vdmulato/EEC136AB-Winter2023-India-Digital-Camera/Pictures/Multiplexer test circuit.jpeg

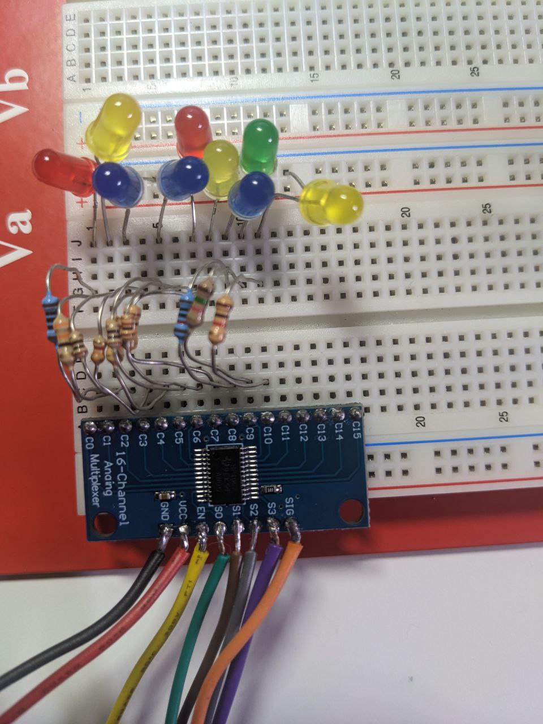
Pictures/Multiplexer test circuit.jpeg
