vdmulato/EEC136AB-Winter2023-India-Digital-Camera/Pictures/Fixed issues.jpg

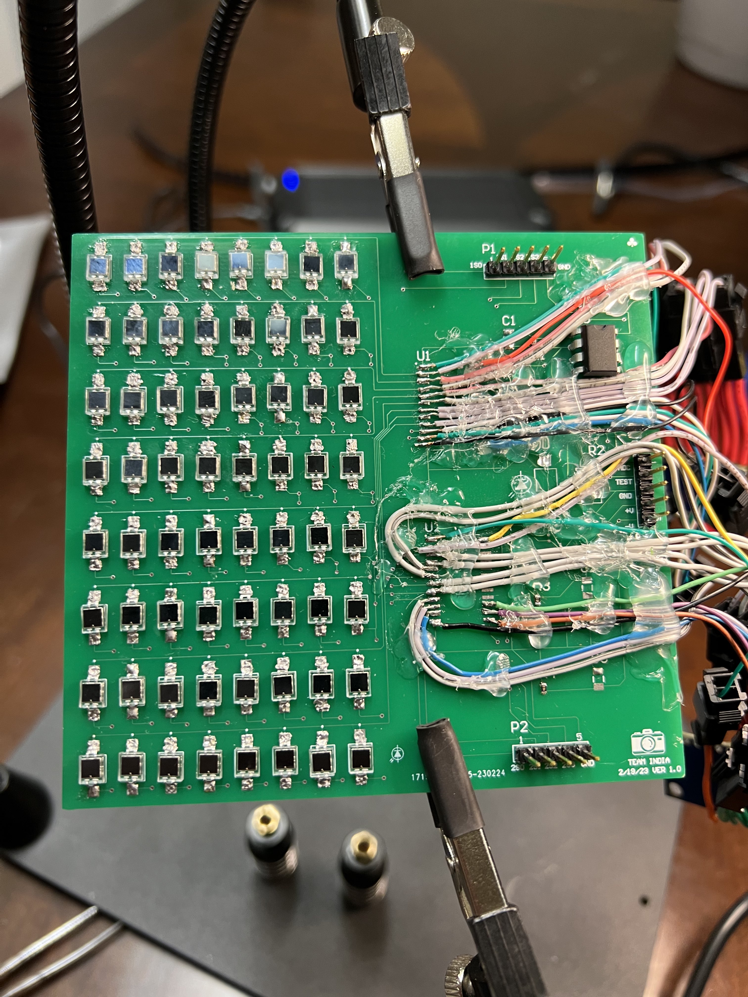
Pictures/Fixed issues.jpg
