vdmulato/EEC136AB-Winter2023-India-Digital-Camera/Weekley reports/Week 5/Week 5 Update.pdf

# EEC136 Digital Camera

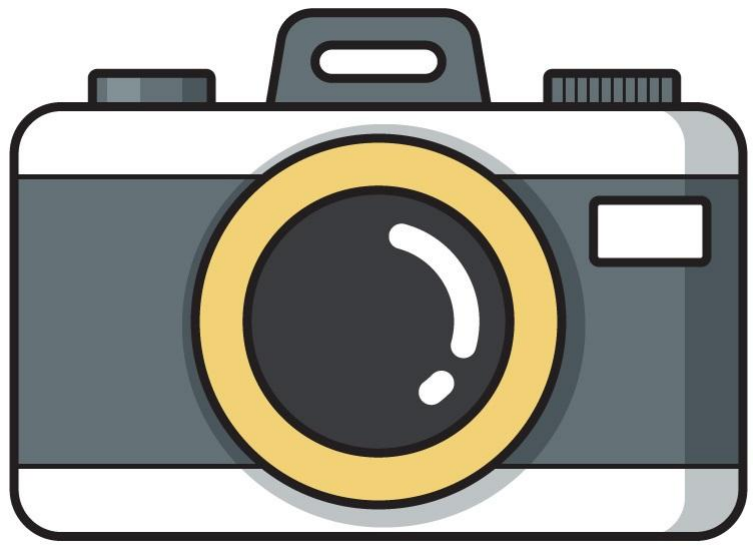
[picture p12: figure]

## Week 5 Project Update

## Waylon, Cassandra, Viktor, Alina, Angel

# Overview

## 1. Received PSoC boards and began assembly 2. Finalized Beta Prototype Design 3. Improved and optimized Matlab code 4. Translating Design into Altium. Intend to order PCB for photodiodes by mid next week 5. Filmed presentation video

# Waylon

This week:

- Filmed and edited presentation video
- Updated Beta Prototype Circuit and designed in LTSpice
- Finalized BOM
- Calculated power consumption and submitted videos

Next week:

- Translate LTSpice design into Altium
- Place order for Photodiode and transimpedance amplifier board
- Place order for parts needed for PCB assembly
- Test PSoC board to fix ground issue
- Begin designs for physical enclosure.

# Alina

This week:

- Hardware - Tested out the multiplexer on the breadboard with Viktor
- Researched other ways of what to include since multiplexer has problems. Researched mosfet and multiplexer parts.

Plans for next week:

- PCB Design - Send a PCB layout to the manufacturer
- Hardware - Test out the connections of the PCB custom PSoC

# Viktor

This week:

- Hardware -Worked with the team to put the Psoc custom board together.
- Worked with the team to conceptualize the last week feedback on the new final design.
- Double checked multiplexer behavior with Alina.
- Management- Recorded the presentation video with the team and recorder the firmware video with Angel.

Plans for next week:

- PCB Design - Help the team on creating the Altium library with new parts.
- Hardware - Research and order new multiplexer for the final design.

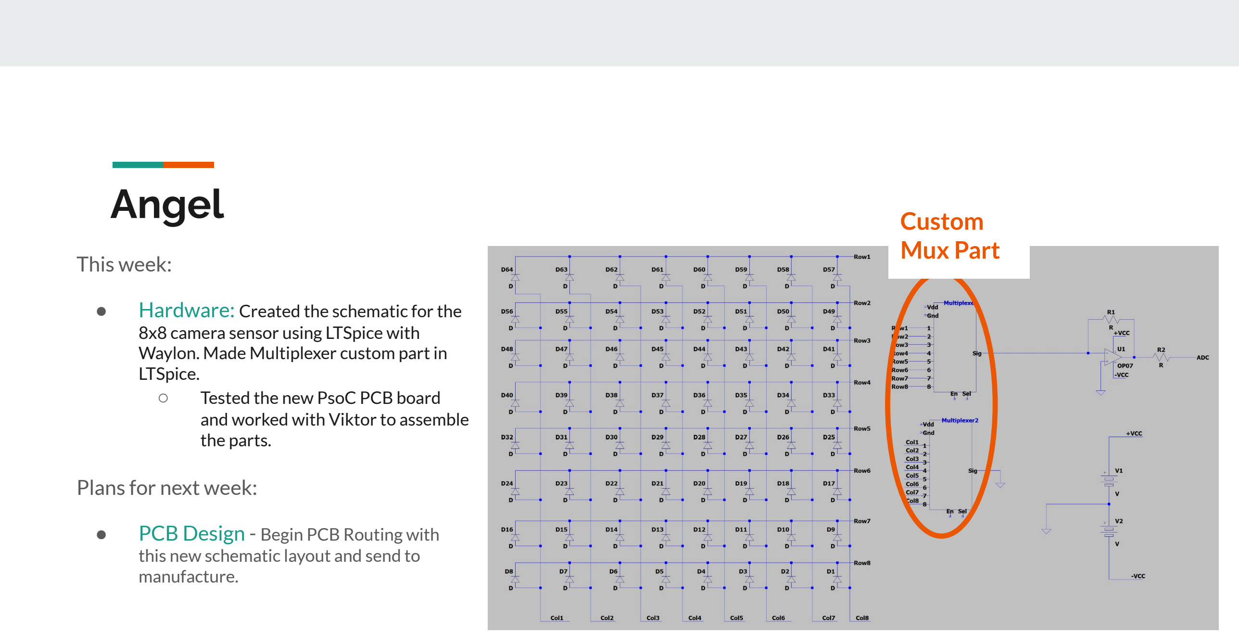
[picture p13: page 6]

# Angel

This week: ● Hardware: Created the schematic for the

8x8 camera sensor using LTSpice with Waylon. Made Multiplexer custom part in LTSpice. ○ Tested the new PsoC PCB board

and worked with Viktor to assemble the parts.

Plans for next week: ● PCB Design - Begin PCB Routing with

this new schematic layout and send to manufacture.

Custom
Mux Part

# Cassandra

This week:
- Software - Upgraded
MATLAB image
processing code to
accept any size of
(square) pixel array
- Misc - Assisted with
board testing, design
finalization, video
recording

Plans for next week:

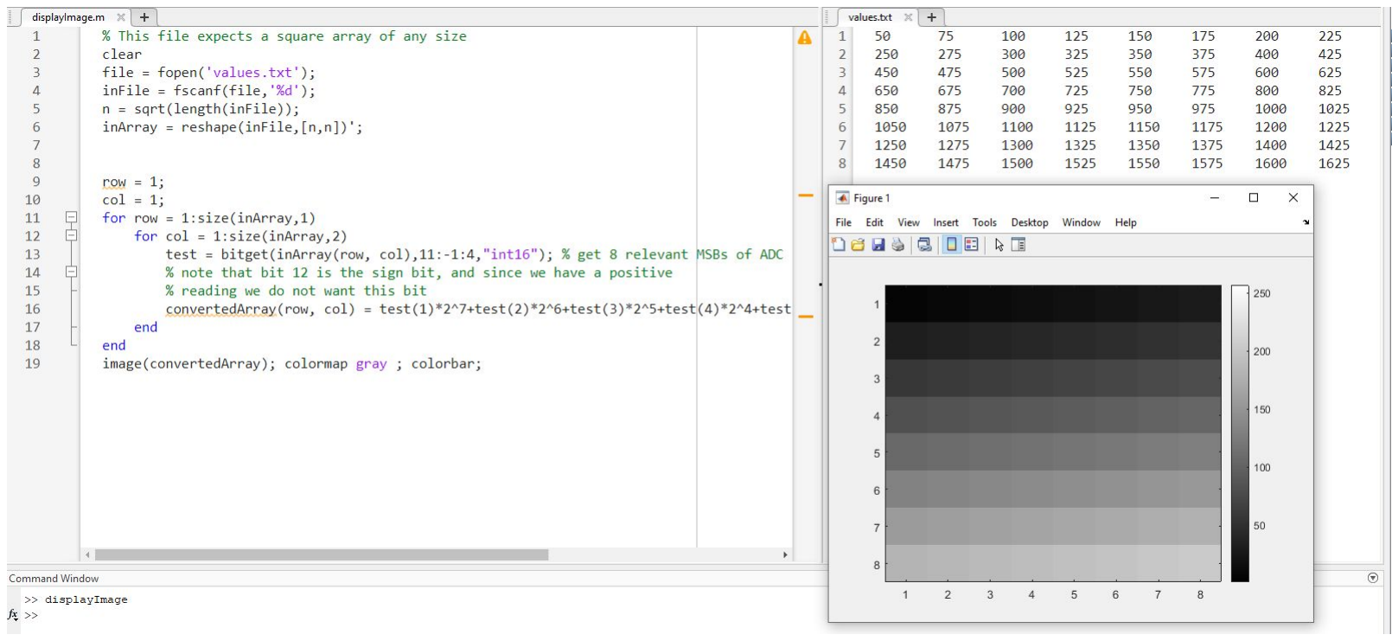
[picture p14: figure]

- Software - Further refine MATLAB code to process files generated by PuTTY
- Hardware - Assist with soldering and testing prototype boards and new components

# Reference Images

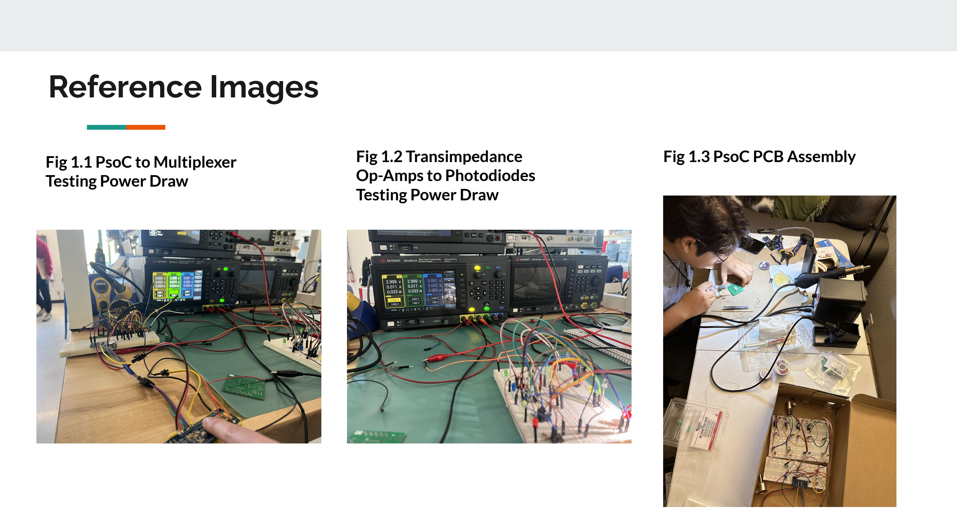
[picture p15: page 8]

Fig 1.1 PsoC to Multiplexer Testing Power Draw

Fig 1.2 Transimpedance
Op-Amps to Photodiodes
Testing Power Draw

Fig 1.3 PsoC PCB Assembly

# Reference Images

Fig 1.4 Sensor PCB Schematic

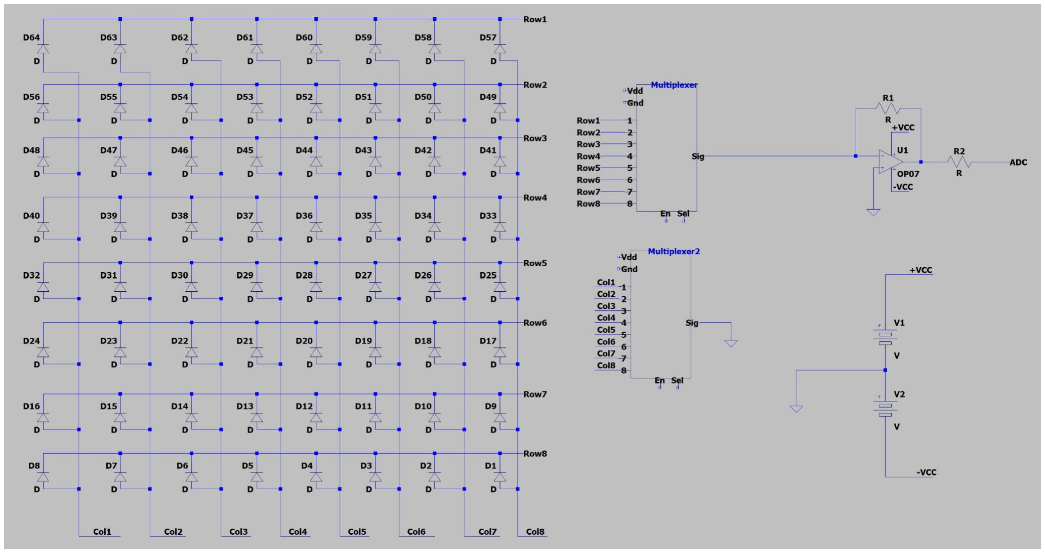
[picture p16: figure]
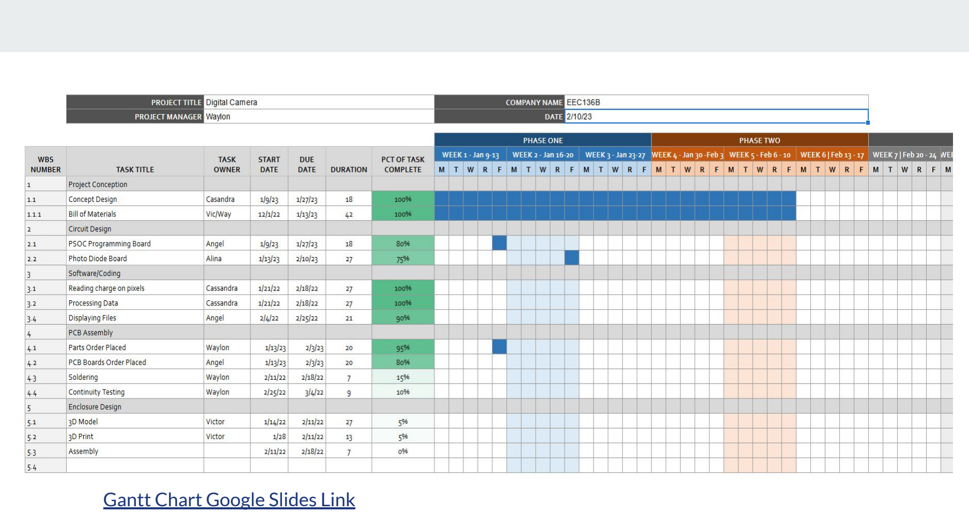
[picture p17: page 10]

Gantt Chart Google Slides Link (https://docs.google.com/spreadsheets/d/1wo6-4W0_o3KltN52uBX6xlA9TMSRVw0D3fkvswnoc7U/edit?usp=sharing)

# Bill of Materials Page 1 of 2

Item | Part No. | QTY | Cost | Received
Photodiode (final board) | VBPW34S (https://www.mouser.com/ProductDetail/Vishay-Semiconductors/VBPW34S?qs=Uj7aA%252BCqp8ZDwjFKEZ8K8A%3D%3D) | 64 | $54.00
MOSFET (n-type) | SQ1922AEEH-T1_GE3 (https://www.mouser.com/ProductDetail/Vishay-Siliconix/SQ1922AEEH-T1_GE3?qs=vLWxofP3U2xgTHPynqtGhQ%3D%3D) | 200 | $60.20 | X
Button | 474-COM-08720 | 5 | $5.25 | X
Header Pins | HDR100IMP40M-G-V-TH | 10 | $4.95 | X
PSOC | CYBLE-416045-02 | 2 | TBD | X
Crystal Oscillator | ECS-2520MV-250-CL-TR | 1 | TBD | X
Battery | LIPO Battery (3.7V) (https://www.sparkfun.com/products/13854) | 1 | $10.95 | X
OLED Display | LCD-13003 (https://www.digikey.com/en/products/detail/sparkfun-electronics/LCD-13003/5673774) | 2 | $35.76
Tri-LED | HSMD-C191 (https://www.mouser.com/ProductDetail/Broadcom-Avago/HSMD-C191?qs=YDL0qNrpDT5JaOo6lomf0A%3D%3D) | 5 | TBD | X
Multiplexer | BOB-13906 (https://www.digikey.com/en/products/detail/sparkfun-electronics/BOB-13906/6193600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) | 2 | $5.90

# Bill of Materials Page 2 of 2

Item | Part No. | QTY | Cost | Received
10KΩ Resistor | 3503G2B10K7FTDF (https://www.mouser.com/ProductDetail/TE-Connectivity-Holsworthy/3503G2B10K7FTDF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) | 4 | $6.56 | X
0Ω Resistor | MCT0603HZ0000ZP500 (https://www.mouser.com/ProductDetail/Vishay-Beyschlag/MCT0603HZ0000ZP500) | 10 | $6.10 | X
1KΩ Resistor | RA73F1J143RBTDF | 2 | $3.88 | X
10uF Capacitor | GMK316BJ106KL-T | 1 | $0.33 | X
22pF Capacitor | 12065A220JAT2A (https://www.mouser.com/ProductDetail/KYOCERA-AVX/12065A220JAT2A) | 2 | $2.80 | X
4.7KΩ Resistor | 263-4.7K-RC (https://www.mouser.com/ProductDetail/Xicon/263-4.7K-RC?qs=a0v42acnAci7EwAcARtcvw%3D%3D) | 2 | $0.20 | X
330Ω Resistor | CMP0805-FX-3300ELF (https://www.mouser.com/ProductDetail/Bourns/CMP0805-FX-3300ELF?qs=TiOZkKH1s2RwjX33o416uQ%3D%3D) | 1 | $0.21 | X
220Ω Resistor | CRGCQ2512F220K (https://www.mouser.com/ProductDetail/TE-Connectivity-Holsworthy/CRGCQ2512F220K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) | 8 | $3.68 | X
470Ω Resistor | CRG0603F470R | 1 | $0.14 | X
