vdmulato/EEC136AB-Winter2023-India-Digital-Camera/Weekley reports/Week 6/Week 6 Update.pdf

# EEC136 Digital Camera

# Week 6 Project Update


# Waylon, Cassandra, Viktor, Alina, Angel

# Overview

## 1. Assembled PSoC boards 2. Tested out the ADC component 3. Improved and optimized Matlab code 4. Finalized Altium design for the photodiodes

# Waylon

This week:

- Worked with Viktor to resolve issues with ADC.
- Worked with Alina to create PCB in Altium.
- Finalized orders for necessary SMD components.

Next week:

- Place order for PCB this weekend after Altium designs are finalized.
- Work with Viktor and Angel with any coding optimizations while waiting for boards.
- Begin developing final report and educational manual.

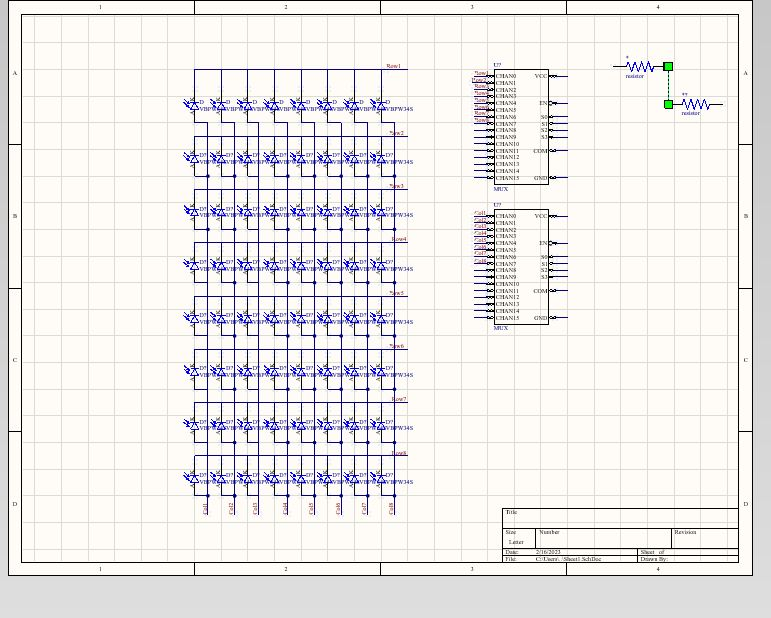
[picture p18: figure]

# Alina

This week:

- Worked on the schematic for the photodiode board on Altium to begin routing.

Plans for next week:

- PCB Design - Work on the assembly of the photodiode board if it arrives
- Hardware - Test out the ways of how to get ADC working

# Viktor

This week:

- Worked through issues with grounding causing erroneous readings on the ADC and Multiplexers.
- Updated PSoC code that allowed ADC readings to occur at the same time as multiplexer switching causing erroneous readings.

Plans for next week:

- Receive photodiode PCBs and begin assembly.
- Work with team on developing final report.

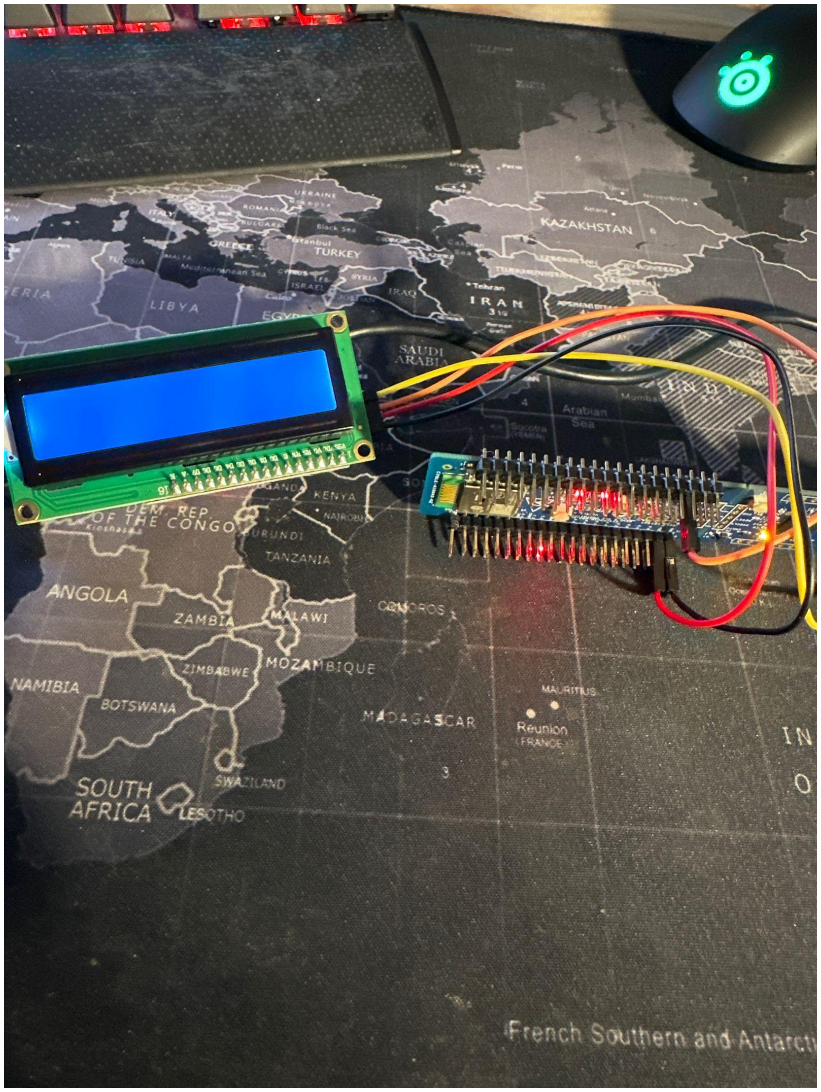
[picture p19: figure]

# Angel

This week:

- Hardware: Figuring out a way to communicate to a LCD screen with I2C to display text for User Interface.
- Code: Debugged Viktor’s Psoc code to read the correct ADC values into putty for image processing.
- Researched further on UART communicating through MatLab directly from the Psoc port. Cassandra was able to implement the readings using this method, and potentially have a live code.

Plans for next week:

- Start thinking about the enclosure based on all the components that we will have.
- Focus on soldering the new PCB that will be sent to manufacture today, hopefully receive it next week.

# Cassandra

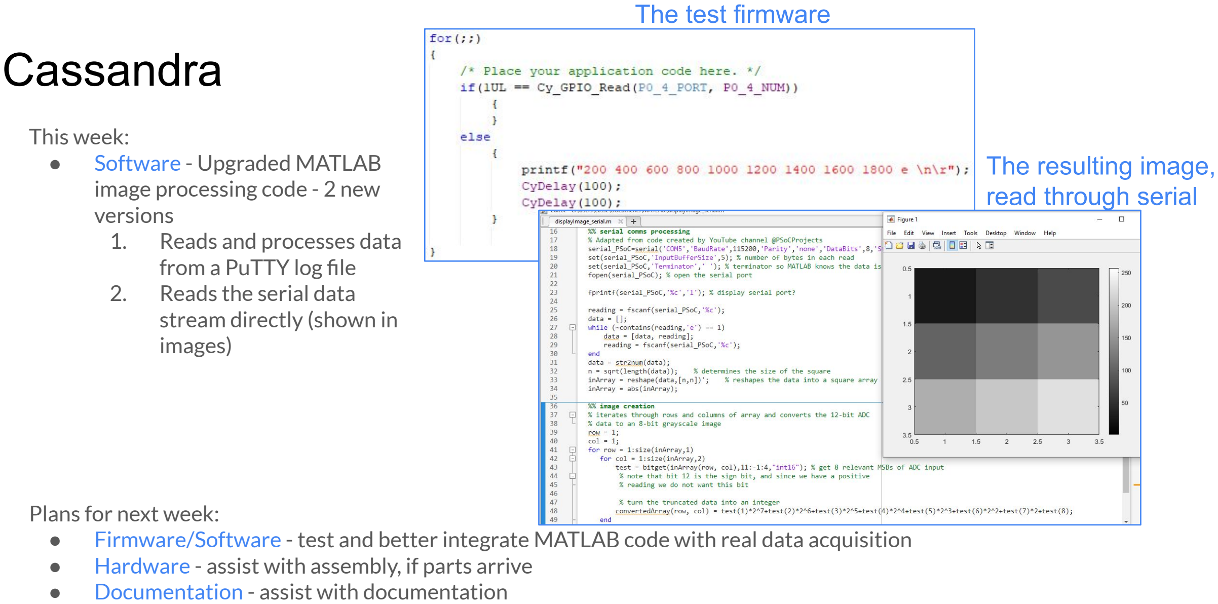
[picture p20: page 7]

This week:
- Software - Upgraded MATLAB image processing code - 2 new versions
1. Reads and processes data from a PuTTY log file
2. Reads the serial data
stream directly (shown in
images)

Plans for next week:
- Firmware/Software - test and better integrate MATLAB code with real data acquisition
- Hardware - assist with assembly, if parts arrive
- Documentation - assist with documentation

The test firmware

The resulting image,
read through serial

# Reference Images

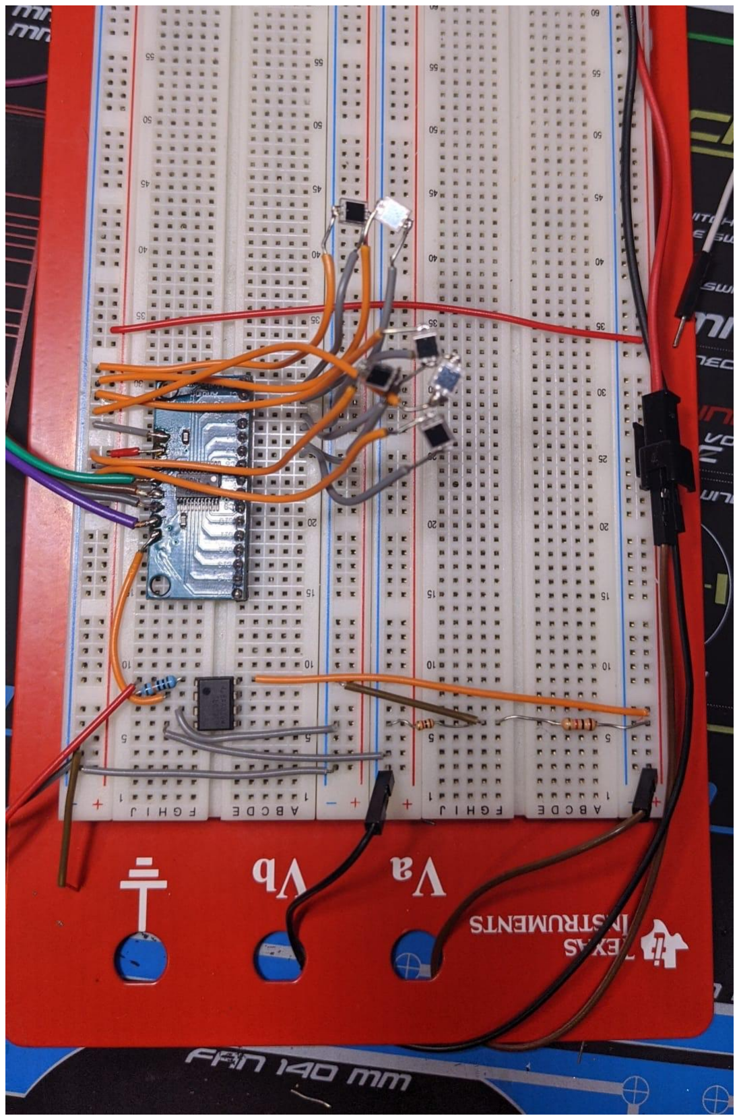
[picture p21: figure]

Fig 1.1 New Multiplexer
Layout

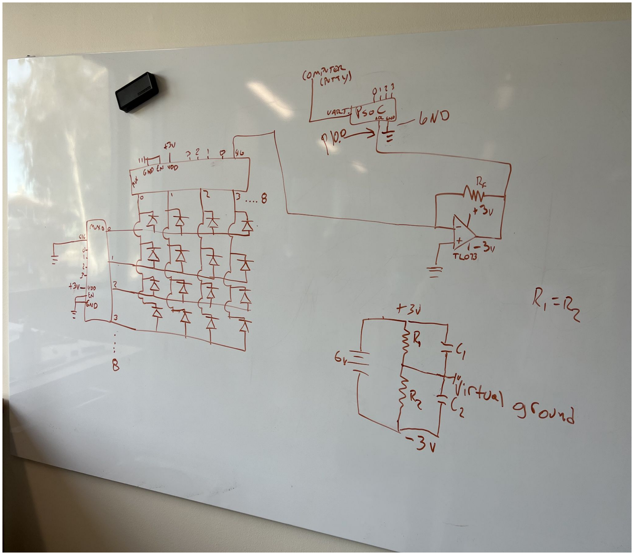
[picture p22: figure]

Fig 1.2 Whole Schematic
Diagram

Fig 1.3 PsoC PCB Assembly

# Reference Images

Fig 1.4 Sensor PCB Schematic

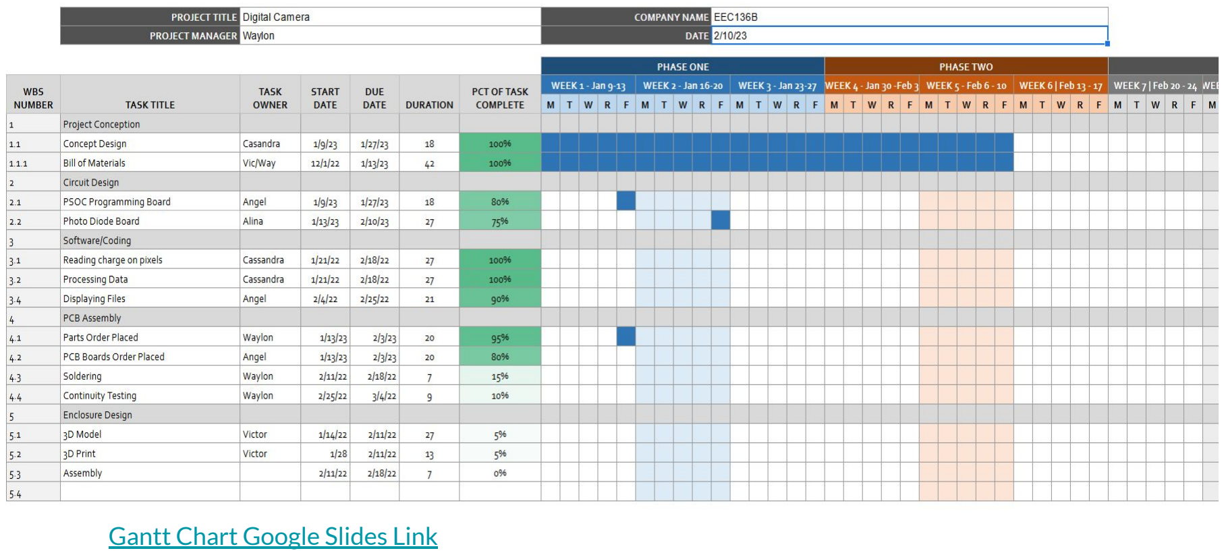
[picture p23: page 10]

Gantt Chart Google Slides Link (https://docs.google.com/spreadsheets/d/1wo6-4W0_o3KltN52uBX6xlA9TMSRVw0D3fkvswnoc7U/edit?usp=sharing)

# Bill of Materials Page 1 of 2

Item | Part No. | QTY | Cost | Received
Photodiode (final board) | VBPW34S (https://www.mouser.com/ProductDetail/Vishay-Semiconductors/VBPW34S?qs=Uj7aA%252BCqp8ZDwjFKEZ8K8A%3D%3D) | 64 | $54.00
MOSFET (n-type) | SQ1922AEEH-T1_GE3 (https://www.mouser.com/ProductDetail/Vishay-Siliconix/SQ1922AEEH-T1_GE3?qs=vLWxofP3U2xgTHPynqtGhQ%3D%3D) | 200 | $60.20 | X
Button | 474-COM-08720 | 5 | $5.25 | X
Header Pins | HDR100IMP40M-G-V-TH | 10 | $4.95 | X
PSOC | CYBLE-416045-02 | 2 | TBD | X
Crystal Oscillator | ECS-2520MV-250-CL-TR | 1 | TBD | X
Battery | LIPO Battery (3.7V) (https://www.sparkfun.com/products/13854) | 1 | $10.95 | X
OLED Display | LCD-13003 (https://www.digikey.com/en/products/detail/sparkfun-electronics/LCD-13003/5673774) | 2 | $35.76
Tri-LED | HSMD-C191 (https://www.mouser.com/ProductDetail/Broadcom-Avago/HSMD-C191?qs=YDL0qNrpDT5JaOo6lomf0A%3D%3D) | 5 | TBD | X
Multiplexer | BOB-13906 (https://www.digikey.com/en/products/detail/sparkfun-electronics/BOB-13906/6193600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) | 2 | $5.90

# Bill of Materials Page 2 of 2

Item | Part No. | QTY | Cost | Received
10KΩ Resistor | 3503G2B10K7FTDF (https://www.mouser.com/ProductDetail/TE-Connectivity-Holsworthy/3503G2B10K7FTDF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) | 4 | $6.56 | X
0Ω Resistor | MCT0603HZ0000ZP500 (https://www.mouser.com/ProductDetail/Vishay-Beyschlag/MCT0603HZ0000ZP500) | 10 | $6.10 | X
1KΩ Resistor | RA73F1J143RBTDF | 2 | $3.88 | X
10uF Capacitor | GMK316BJ106KL-T | 1 | $0.33 | X
22pF Capacitor | 12065A220JAT2A (https://www.mouser.com/ProductDetail/KYOCERA-AVX/12065A220JAT2A) | 2 | $2.80 | X
4.7KΩ Resistor | 263-4.7K-RC (https://www.mouser.com/ProductDetail/Xicon/263-4.7K-RC?qs=a0v42acnAci7EwAcARtcvw%3D%3D) | 2 | $0.20 | X
330Ω Resistor | CMP0805-FX-3300ELF (https://www.mouser.com/ProductDetail/Bourns/CMP0805-FX-3300ELF?qs=TiOZkKH1s2RwjX33o416uQ%3D%3D) | 1 | $0.21 | X
220Ω Resistor | CRGCQ2512F220K (https://www.mouser.com/ProductDetail/TE-Connectivity-Holsworthy/CRGCQ2512F220K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) | 8 | $3.68 | X
470Ω Resistor | CRG0603F470R | 1 | $0.14 | X
