vdmulato/EEC136AB-Winter2023-India-Digital-Camera/Weekley reports/Week 7/Week 7 Update.pdf

# EEC136 Digital Camera

# Week 7 Project Update


# Waylon, Cassandra, Viktor, Alina, Angel

# Overview

## 1. Sent out Photodiode board PCB to Smart Prototyping 2. Worked on code for LCD display to show camera indication 3. Ordered all parts still missing for assembly

4. Worked on beta prototype code.

## 5. Build a circuit that resembles the beta PCB to perform testing ahead

of time.

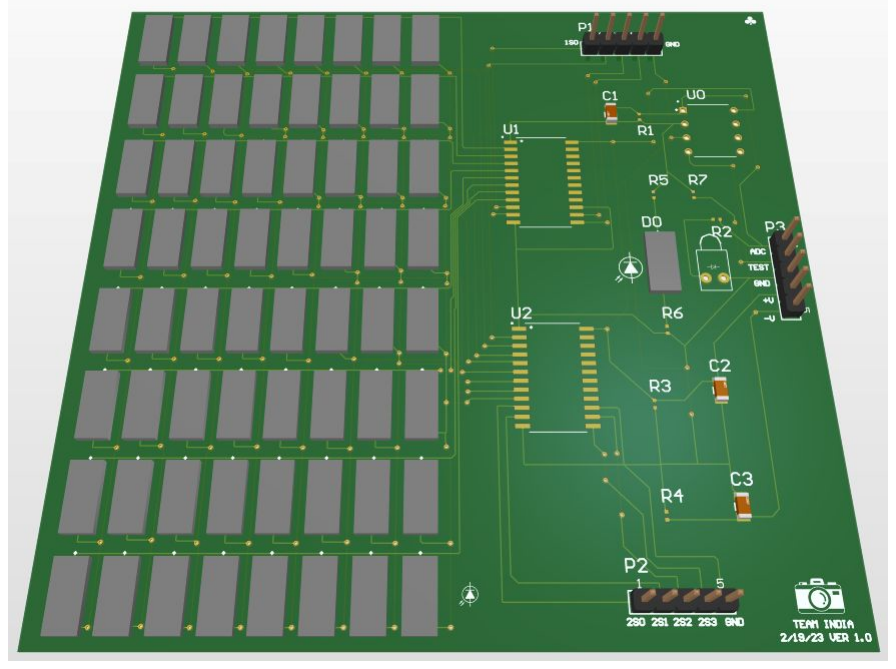
[picture p24: figure]

# Waylon

This week:

- Sent out Photodiode Board to Smart Prototyping after verifying with team.
- Placed order for all parts currently do not have.

Next week:

- Receive photodiode PCB
- Assemble PCB
- Test PCB

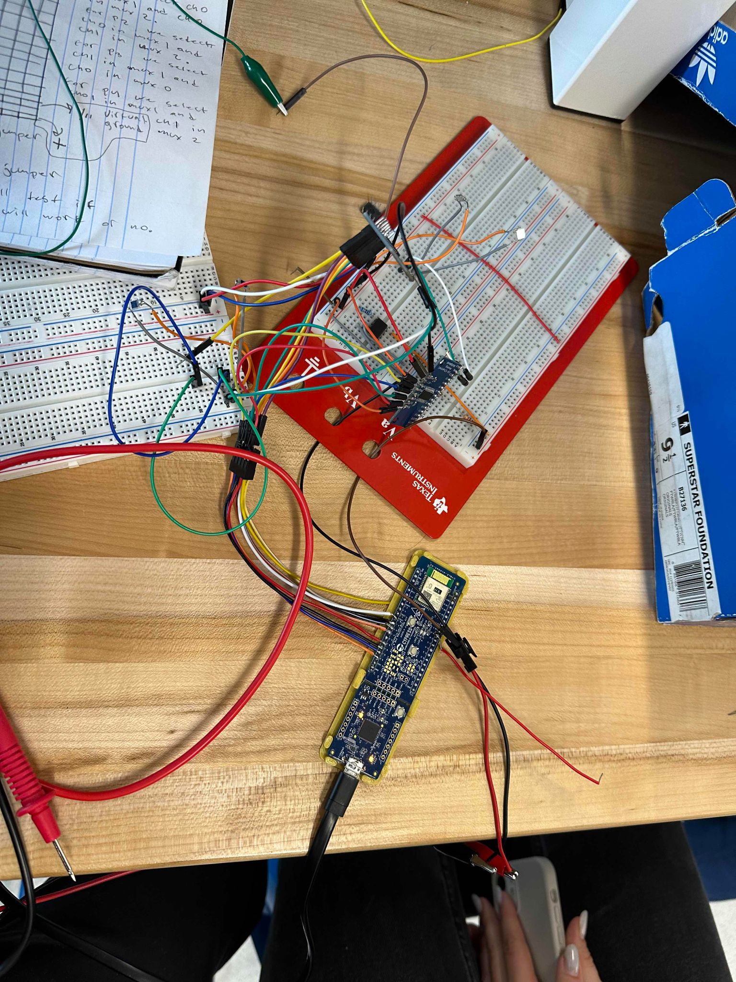
[picture p25: figure]

# Alina

This week:

- Tested out the multiplexer with Viktor to make sure it reads correct values from the selected channels

Plans for next week:

- PCB Design - Work on the assembly of the photodiode board
- Hardware - Connect the photo board with the psoc

# Viktor

This week:

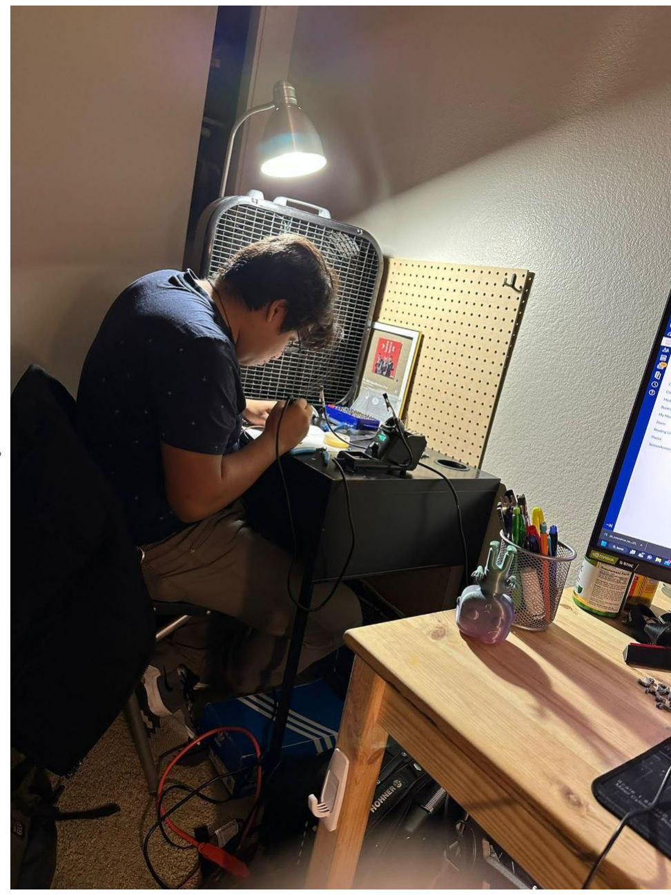
[picture p26: figure]

- Hardware : Build beta prototype circuit and perform testing ahead of time with Alina.
- Code: Updated Psoc code to account for the new PCB layout and components.
- Troubleshooting: Work with the team for alternatives for possibles errors.

Plans for next week:

- Hardware :Help the team with the PCB assembly.
- Documentation: Work with team on developing a report.
- Code: Work on the Psoc code.

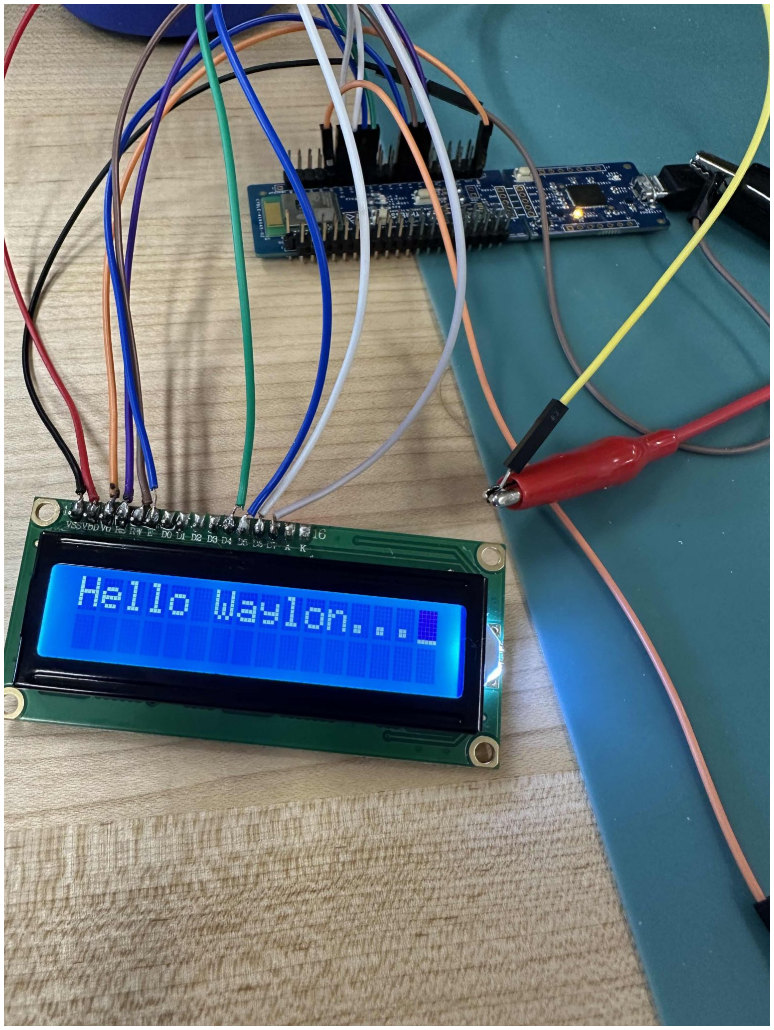
[picture p27: figure]

# Angel

This week:

- Hardware: Configured a library for the LCD screen to work properly and display for the user interface.
- Code: Debugged Viktor’s Psoc multiplexer code to read the correct ADC values into putty for image processing.
- Combined the UART Psoc code with Matlab to create a live image when pressing a button with Cassandra. .

Plans for next week:

- Start thinking about the enclosure based on all the components that we will have.
- Focus on soldering the new PCB that was sent to manufacture, hopefully receive it next week.

# Cassandra

This week:
- Firmware
- Created basic structure
for acquisition loop
- Worked with Angel to test combination of LCD and
UART output, verifying the MATLAB image
processing code in a more
realistic test

Plans for next week:

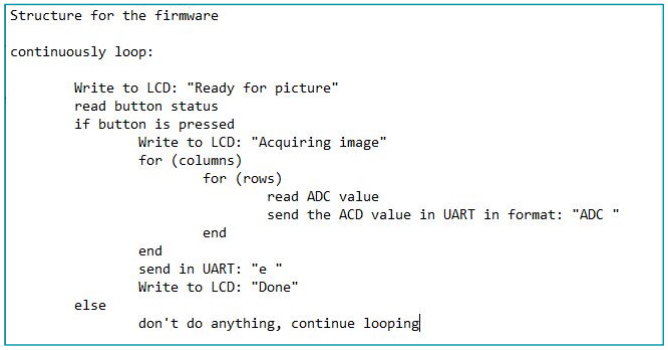
[picture p28: figure]

- Firmware/Software - continue integrating parts of the firmware (e.x. add MUX control code, read actual ADC values)
- Hardware - assist with assembly when parts arrive
- Documentation - assist with documentation

# Reference Images

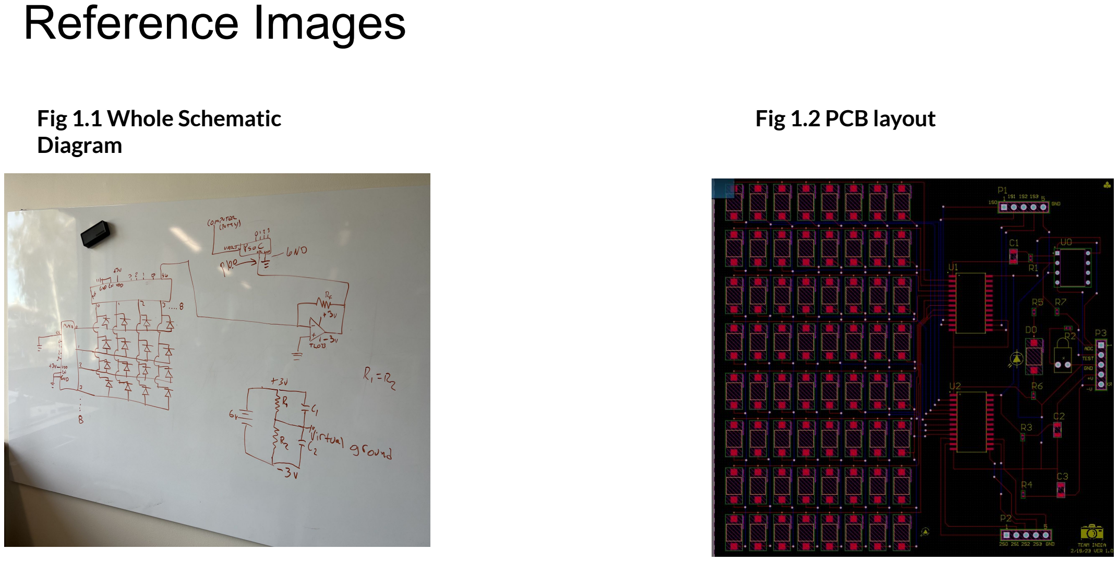
[picture p29: page 8]

Fig 1.1 Whole Schematic
Diagram

Fig 1.2 PCB layout

# Reference Images

Fig 1.4 Sensor PCB Schematic

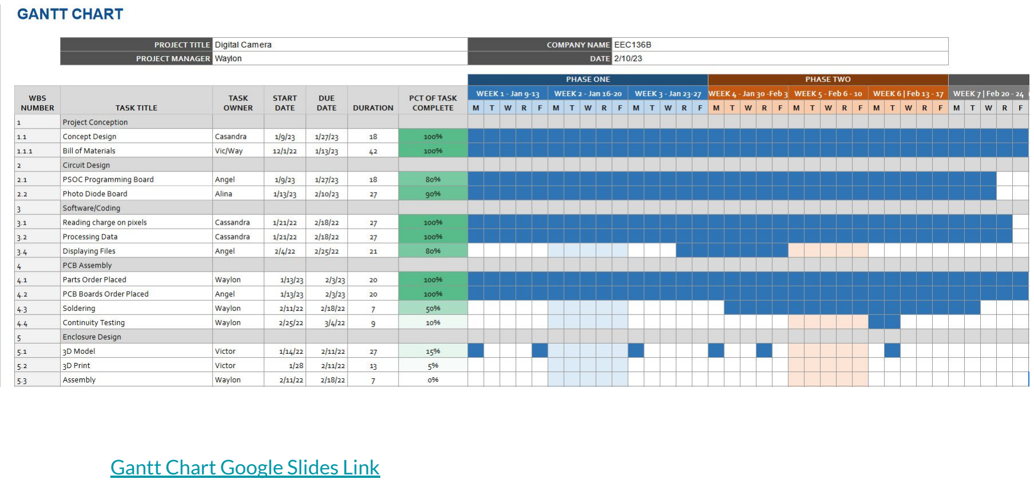
[picture p30: page 10]

Gantt Chart Google Slides Link (https://docs.google.com/spreadsheets/d/1wo6-4W0_o3KltN52uBX6xlA9TMSRVw0D3fkvswnoc7U/edit?usp=sharing)

# Bill of Materials Page 1 of 2

Item | Part No. | QTY | Cost | Received
Photodiode | VBPW34S (https://www.mouser.com/ProductDetail/Vishay-Semiconductors/VBPW34S?qs=Uj7aA%252BCqp8ZDwjFKEZ8K8A%3D%3D) | 64 | $54.00 | X
Button | 474-COM-08720 | 5 | $5.25 | X
Header Pins | HDR100IMP40M-G-V-TH | 10 | $4.95 | X
PSOC | CYBLE-416045-02 | 2 | TBD | X
Crystal Oscillator | ECS-2520MV-250-CL-TR | 1 | TBD
Battery | LIPO Battery (3.7V) (https://www.sparkfun.com/products/13854) | 1 | $10.95 | X
OLED Display | LCD-13003 (https://www.digikey.com/en/products/detail/sparkfun-electronics/LCD-13003/5673774) | 2 | $35.76 | X
Tri-LED | HSMD-C191 (https://www.mouser.com/ProductDetail/Broadcom-Avago/HSMD-C191?qs=YDL0qNrpDT5JaOo6lomf0A%3D%3D) | 5 | TBD | X
Multiplexer | BOB-13906 (https://www.digikey.com/en/products/detail/sparkfun-electronics/BOB-13906/6193600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) | 2 | $5.90

# Bill of Materials Page 2 of 2

Item | Part No. | QTY | Cost | Received
10KΩ Resistor | 3503G2B10K7FTDF (https://www.mouser.com/ProductDetail/TE-Connectivity-Holsworthy/3503G2B10K7FTDF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) | 4 | $6.56
0Ω Resistor | MCT0603HZ0000ZP500 (https://www.mouser.com/ProductDetail/Vishay-Beyschlag/MCT0603HZ0000ZP500) | 10 | $6.10
1KΩ Resistor | RA73F1J143RBTDF | 2 | $3.88
10uF Capacitor | GMK316BJ106KL-T | 1 | $0.33
22pF Capacitor | 12065A220JAT2A (https://www.mouser.com/ProductDetail/KYOCERA-AVX/12065A220JAT2A) | 2 | $2.80
4.7KΩ Resistor | 263-4.7K-RC (https://www.mouser.com/ProductDetail/Xicon/263-4.7K-RC?qs=a0v42acnAci7EwAcARtcvw%3D%3D) | 2 | $0.20
330Ω Resistor | CMP0805-FX-3300ELF (https://www.mouser.com/ProductDetail/Bourns/CMP0805-FX-3300ELF?qs=TiOZkKH1s2RwjX33o416uQ%3D%3D) | 1 | $0.21
220KΩ Resistor | CRGCQ2512F220K (https://www.mouser.com/ProductDetail/TE-Connectivity-Holsworthy/CRGCQ2512F220K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) | 8 | $3.68
470Ω Resistor | CRG0603F470R | 1 | $0.14
