vdmulato/EEC136AB-Winter2023-India-Digital-Camera/Weekley reports/Week 8/Week 8 Update.pdf

# EEC136 Digital Camera

# Week 8 Project Update


# Waylon, Cassandra, Viktor, Alina, Angel

# Overview

## 1. Received Photodiode board PCB 2. Worked on code for LCD display to show camera indication 3. Received all parts for assembly

4. Worked on beta prototype code.
5. Start the PCB assembly.

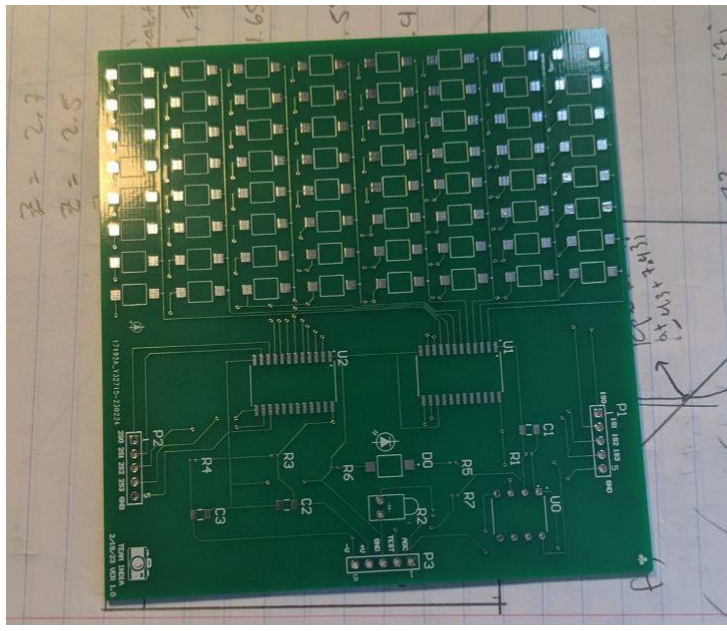
[picture p31: figure]

# Waylon

This week:

- Received photodiode PCB after weather delays
- Ordered missing resistor values

Next week:

- Assemble PCB
- Test PCB

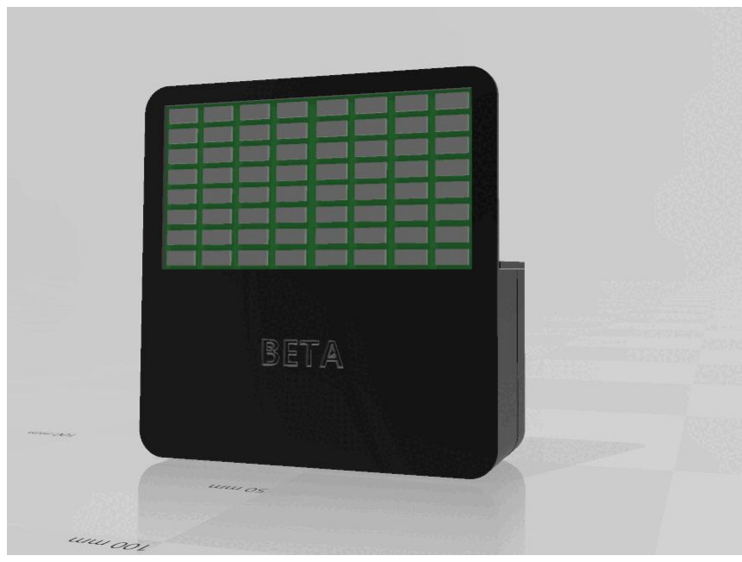
[picture p32: figure]

# Alina

This week:

- Work on the concept for the 3D beta enclosure with Viktor.
- Help with the logistics of receiving the board.

Plans for next week:

- Software - Help with the final details for the board
- Hardware - Help testing the board.

# Viktor

This week:

- Troubleshooting: Perform testing on the board.
- Design: Help Alina with the 3D beta model.

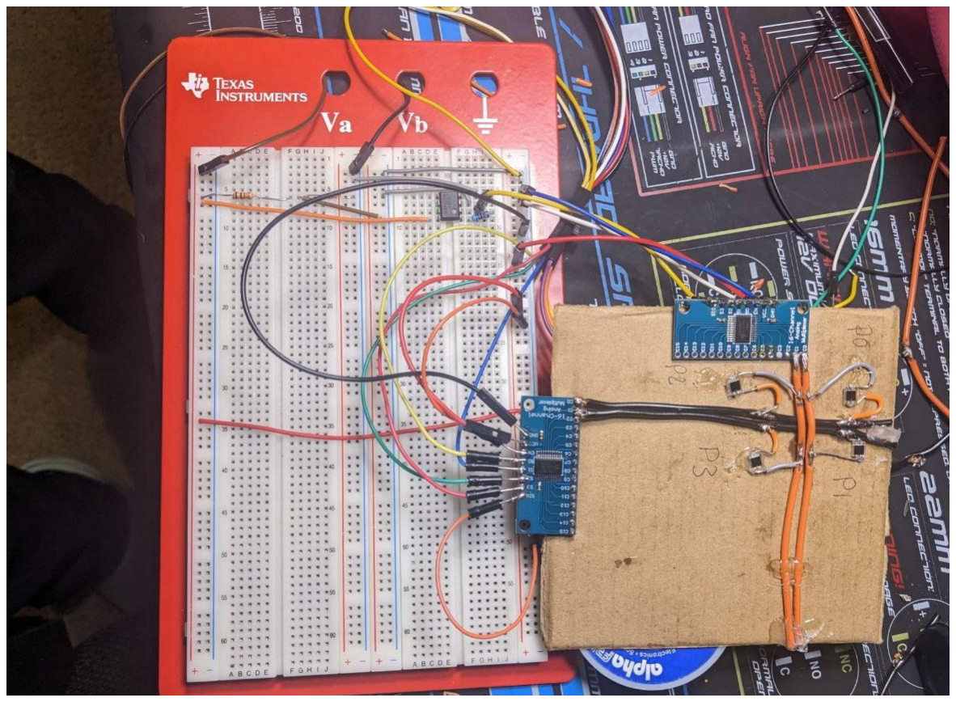
[picture p33: figure]

- Troubleshooting: Work with the team for alternatives for possibles errors.

Plans for next week:

- Hardware : Help with the PCB assembly
- 3D: Printing the model.
- Code: Work on the Psoc code details.

# Angel

This week:

- Hardware: Made sure connections from prototype can be read accordingly with the code. Soldering parts to newly received PCB on this upcoming Saturday.
- Code: Fixed the logic to change the multiplexers position and changed features of LCD to display correct messages.
- Made sure the readings are actually being sent out through UART for MatLab connection.

Plans for next week:

- Focus on soldering the new PCB that was sent to manufacture, now we received it.
- Start testing both PCB to make the final product enclosure.

# Cassandra

This week:
- Nothing :(

Plans for next week:
- Hardware - assist with PCB assembly, testing, and troubleshooting
- Documentation - update documentation

# Reference Images

Fig 1.4 Sensor PCB Schematic


Gantt Chart Google Slides Link (https://docs.google.com/spreadsheets/d/1wo6-4W0_o3KltN52uBX6xlA9TMSRVw0D3fkvswnoc7U/edit?usp=sharing)

# Bill of Materials Page 1 of 2

Item | Part No. | QTY | Cost | Received
Photodiode | VBPW34S (https://www.mouser.com/ProductDetail/Vishay-Semiconductors/VBPW34S?qs=Uj7aA%252BCqp8ZDwjFKEZ8K8A%3D%3D) | 64 | $54.00 | X
Button | 474-COM-08720 | 5 | $5.25 | X
Header Pins | HDR100IMP40M-G-V-TH | 10 | $4.95 | X
PSOC | CYBLE-416045-02 | 2 | TBD | X
Crystal Oscillator | ECS-2520MV-250-CL-TR | 1 | TBD
Battery | LIPO Battery (3.7V) (https://www.sparkfun.com/products/13854) | 1 | $10.95 | X
OLED Display | LCD-13003 (https://www.digikey.com/en/products/detail/sparkfun-electronics/LCD-13003/5673774) | 2 | $35.76 | X
Tri-LED | HSMD-C191 (https://www.mouser.com/ProductDetail/Broadcom-Avago/HSMD-C191?qs=YDL0qNrpDT5JaOo6lomf0A%3D%3D) | 5 | TBD | X
Multiplexer | BOB-13906 (https://www.digikey.com/en/products/detail/sparkfun-electronics/BOB-13906/6193600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) | 2 | $5.90

# Bill of Materials Page 2 of 2

Item | Part No. | QTY | Cost | Received
10KΩ Resistor | 3503G2B10K7FTDF (https://www.mouser.com/ProductDetail/TE-Connectivity-Holsworthy/3503G2B10K7FTDF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) | 4 | $6.56
0Ω Resistor | MCT0603HZ0000ZP500 (https://www.mouser.com/ProductDetail/Vishay-Beyschlag/MCT0603HZ0000ZP500) | 10 | $6.10
1KΩ Resistor | RA73F1J143RBTDF | 2 | $3.88
10uF Capacitor | GMK316BJ106KL-T | 1 | $0.33
22pF Capacitor | 12065A220JAT2A (https://www.mouser.com/ProductDetail/KYOCERA-AVX/12065A220JAT2A) | 2 | $2.80
4.7KΩ Resistor | 263-4.7K-RC (https://www.mouser.com/ProductDetail/Xicon/263-4.7K-RC?qs=a0v42acnAci7EwAcARtcvw%3D%3D) | 2 | $0.20
330Ω Resistor | CMP0805-FX-3300ELF (https://www.mouser.com/ProductDetail/Bourns/CMP0805-FX-3300ELF?qs=TiOZkKH1s2RwjX33o416uQ%3D%3D) | 1 | $0.21
220KΩ Resistor | CRGCQ2512F220K (https://www.mouser.com/ProductDetail/TE-Connectivity-Holsworthy/CRGCQ2512F220K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) | 8 | $3.68
470Ω Resistor | CRG0603F470R | 1 | $0.14
