vdmulato/EEC136AB-Winter2023-India-Digital-Camera/Weekley reports/Week 4/Week 4 Update.pdf

# EEC136 Digital Camera


## Week 3 Project Update

## Waylon, Cassandra, Viktor, Alina, Angel

# Overview

## 1. Built a 2x2 photodiode prototype to display the first image 2. Created a MatLab code to display the 4 pixels in grayscale

3. Debugged errors in prototype circuit.
4. Created alpha report, following the report requirements.

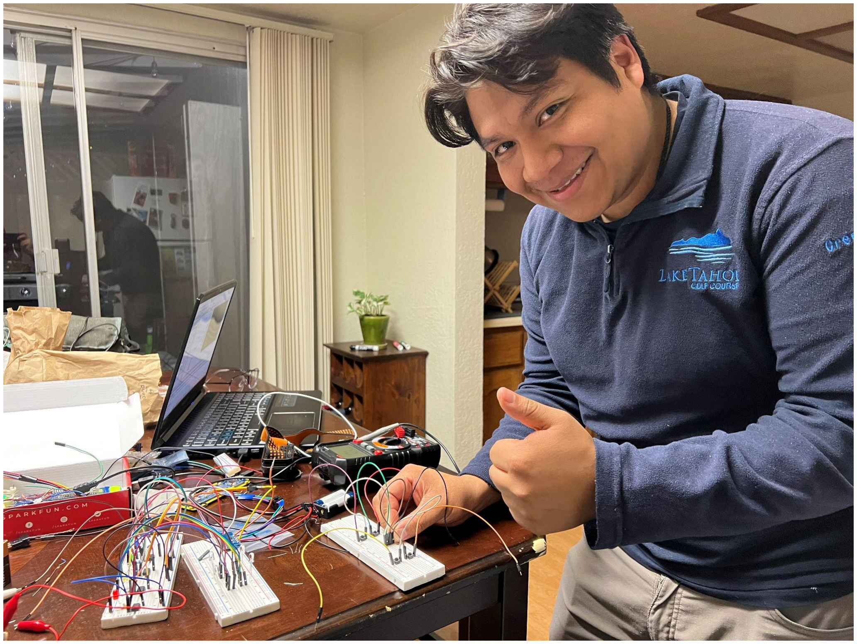
[picture p36: figure]

# Waylon

This week:

- Worked with Viktor to design and build transimpedance amplifier array with output diodes for quick reference.
- Integrated digital multiplexer and built a backup manual multiplexer
- Worked through issues with floating ground causing erroneous readings
- Presented alpha prototype with group

Next week:

- Implement transistor array as described by Professor Amirtharajah
- Create PCB circuit design in Altium
- Order SMD components and boards

(Viktor having a great time testing voltages on February 2nd at 11pm)

# Alina

This week:

- Documentation - Worked on the report and organized it with the IEEE requirements. Included complexity of design, graphs, and amount of hours spent.
- Hardware - Worked on the prototype bring up with group and documented errors to possibly change components.

Plans for next week:

- PCB Design - Work on the design for the finalized PCB board with Waylon.
- Hardware - Find new components for non-polar Op-Amp and follow professors suggestions.

# Viktor

This week:

- Hardware - Worked with Waylon to build and design transimpedance amplifiers with photodiodes to make reference output values.
- Made breadboard circuit for multiplexers that are able to control the photodiode that is to absorb light.
- Code: Made the firmware in Psoc to control the multiplexer in binary outputs and also create the logic to read all photodiode values.

Plans for next week:

- PCB Design - Conceptualize the final circuit board for the 8x8 array of photodiodes.
- Hardware - Follow professors suggestions on the prototype that we suggested. Which is a new circuit that can control the rows and columns with the multiplexer and transistor.

# Angel

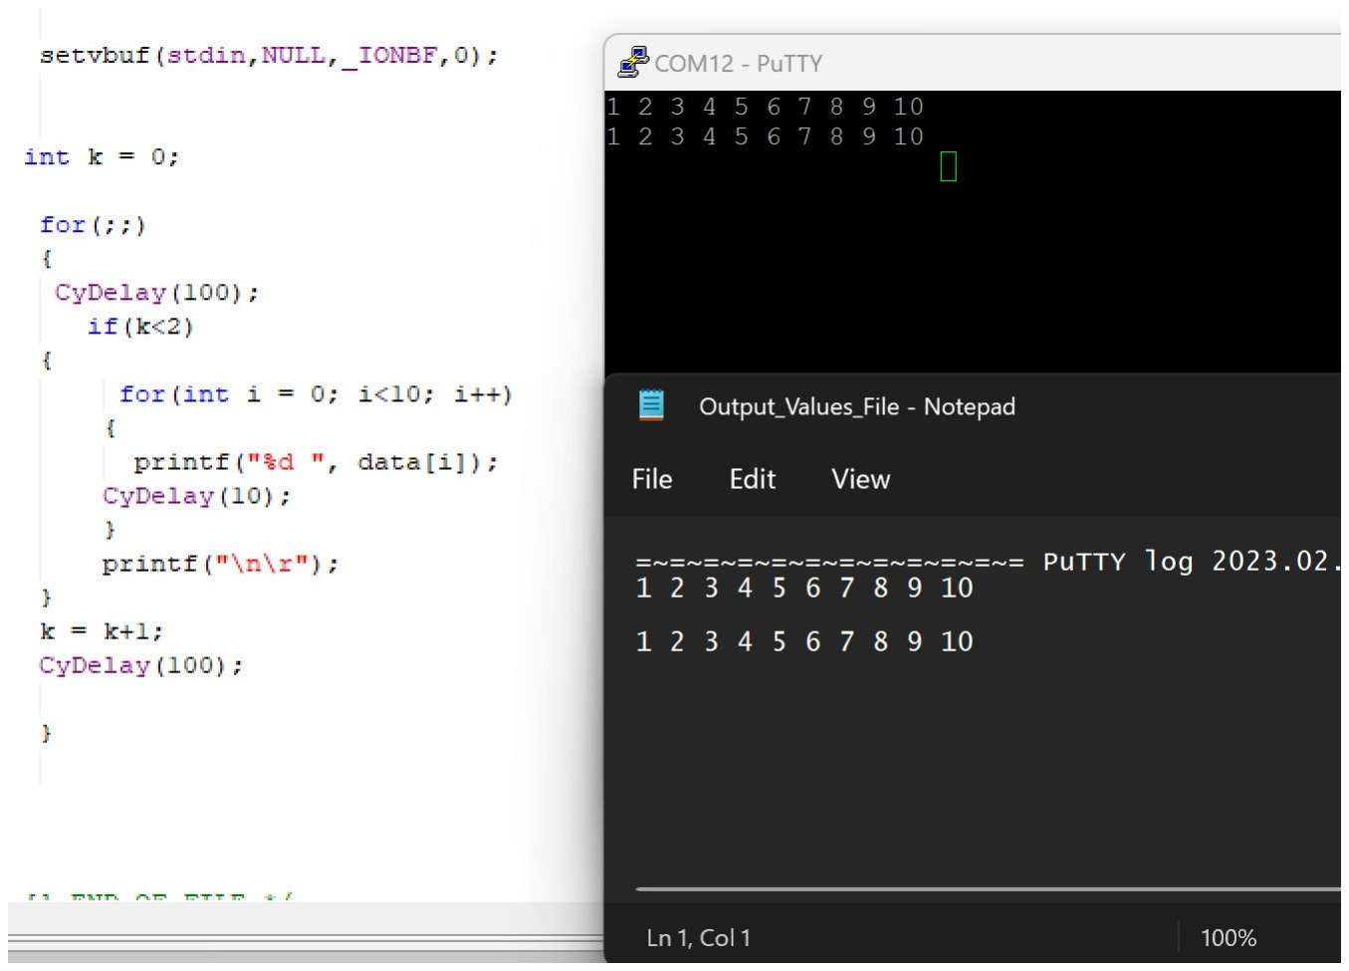
[picture p37: figure]

This week:

- Code - Implementation of ADC value readings through UART and save them in a text file so that MatLab can open this file for image display. The simple method is using Putty to create a log file and MatLab opens it.
- Researched possible internal memory file inside Psoc. This would allow us to use UART and another programming language to extract the internal file.

Plans for next week:

- PCB Design - Work on final schematic design of the whole board to start creating a documentation of a circuit board and begin PCB routing.
- Hardware - Work on the power implementation of all components and find alternative Op-amps/multiplexers.
- Code - Expand the MatLab array for image processing and collect the stored files from Putty or Psoc.

# Cassandra

This week:

- Hardware - Testing and troubleshooting of Alpha prototype
- Software - Created MATLAB code to turn ADC data into images
- Documentation - Assisted with report

Plans for next week:

- Software - Refine MATLAB code for processing files created by PuTTY and accepting arbitrary-sized (square) arrays
- Hardware/Design - Continue troubleshooting issues with multiplexing, test alternative designs for addressing the pixels, test the system with battery power instead of a supply

# Reference Images

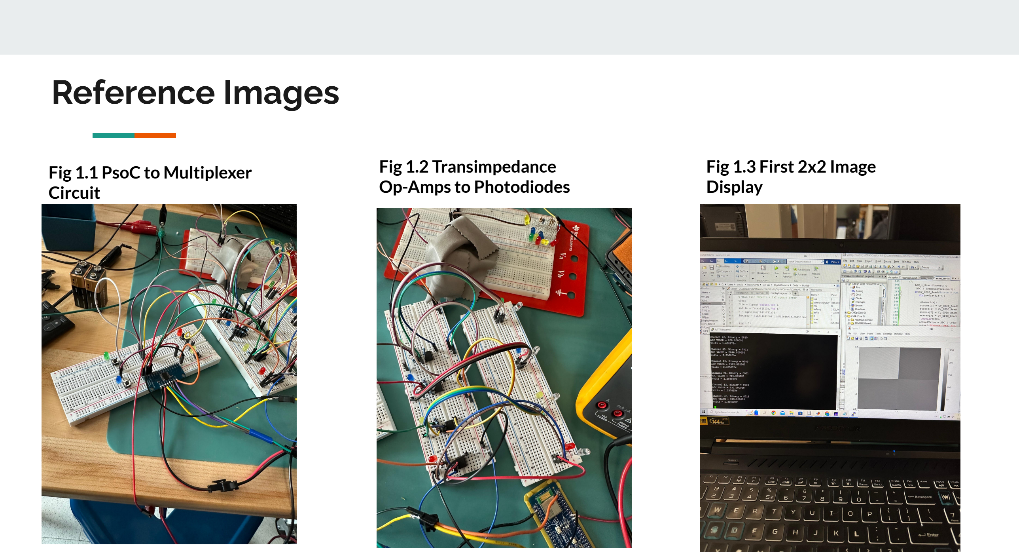
[picture p38: page 8]

Fig 1.1 PsoC to Multiplexer Circuit

Fig 1.2 Transimpedance
Op-Amps to Photodiodes

Fig 1.3 First 2x2 Image
Display

# Reference Images

Fig 1.4 Lab Circuit Setup

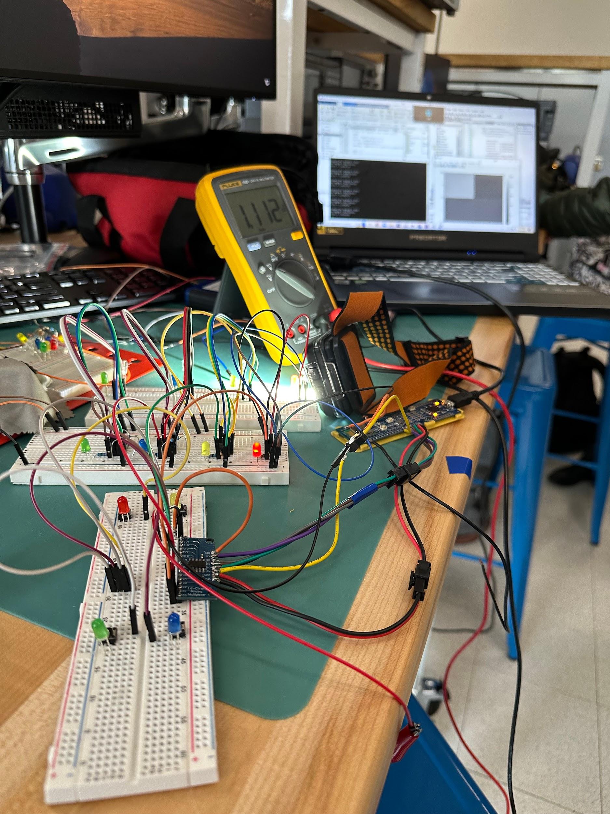
[picture p39: figure]
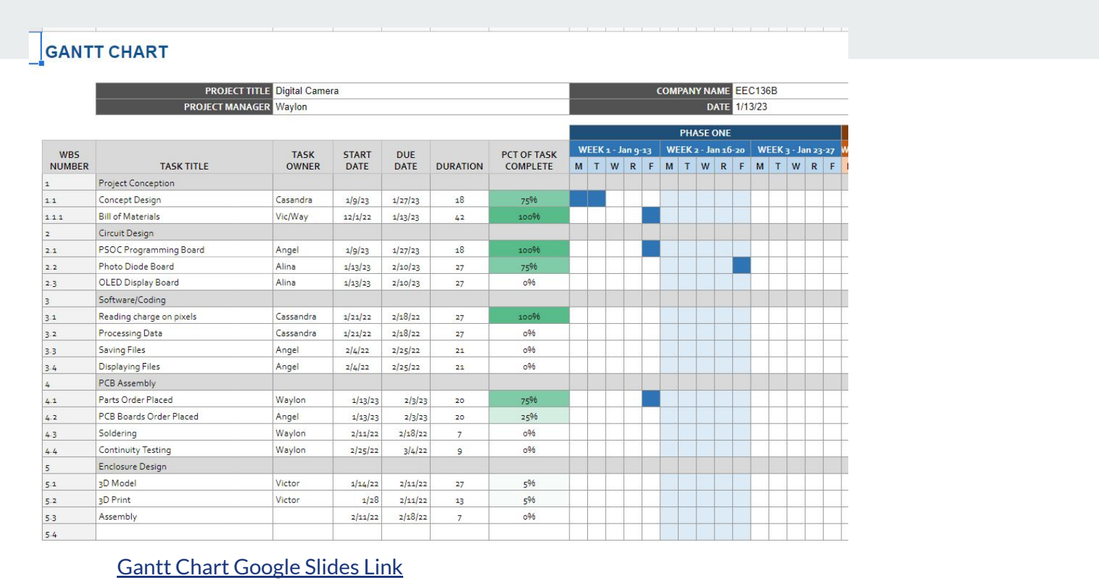
[picture p40: page 10]

Gantt Chart Google Slides Link (https://docs.google.com/spreadsheets/d/1wo6-4W0_o3KltN52uBX6xlA9TMSRVw0D3fkvswnoc7U/edit?usp=sharing)

# Bill of Materials Page 1 of 2

Item | Part No. | QTY | Cost | Received
Photodiode (final board) | VBPW34S (https://www.mouser.com/ProductDetail/Vishay-Semiconductors/VBPW34S?qs=Uj7aA%252BCqp8ZDwjFKEZ8K8A%3D%3D) | 100 | $54.00
Photodiode (breadboard) | 1540051EA3590 (https://www.mouser.com/ProductDetail/Wurth-Elektronik/1540051EA3590?qs=u16ybLDytRaft4DtVWb5gA%3D%3D) | 10 | $7.29 | X
MOSFET (n-type) | SQ1922AEEH-T1_GE3 (https://www.mouser.com/ProductDetail/Vishay-Siliconix/SQ1922AEEH-T1_GE3?qs=vLWxofP3U2xgTHPynqtGhQ%3D%3D) | 200 | $60.20 | X
Button | In lab (https://www.sparkfun.com/products/8720) | 5 | $5.25
Header Pins | In lab (https://www.adafruit.com/product/392) | 10 | $4.95
PSOC | In lab | 2 | TBD
Crystal Oscillator | In lab | 1 | TBD
Battery | LIPO Battery (3.7V) (https://www.sparkfun.com/products/13854) | 1 | $10.95
OLED Display | LCD-13003 (https://www.digikey.com/en/products/detail/sparkfun-electronics/LCD-13003/5673774) | 2 | $35.76
Tri-LED | In lab | 5 | TBD
Multiplexer | BOB-13906 (https://www.digikey.com/en/products/detail/sparkfun-electronics/BOB-13906/6193600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) | 2 | $5.90

# Bill of Materials Page 2 of 2

Item | Part No. | QTY | Cost
10KΩ | TBD | 4 | TBD
0Ω Resistor | TBD | 10 | TBD
1KΩ Resistor | TBD | 2 | TBD
10uF Capacitor | TBD | 1 | TBD
22pF Capacitor | TBD | 2 | TBD
4.7KΩ Resistor | TBD | 2 | TBD
330Ω Resistor | TBD | 1 | TBD
470Ω | TBD | 1 | TBD
