vdmulato/EEC136AB-Winter2023-India-Digital-Camera/Weekley reports/Week 3/Week 3 Update.pdf

# EEC136 Digital Camera


## Week 3 Project Update

## Waylon, Cassandra, Viktor, Alina, Angel

# Overview

1. Began building prototype board and testing photodiodes.
2. Tested prototype with PSoC ADC pins.
3. Power consumption calculations and researched solutions.
4. Tested multiplexer implementation to circuit board.
5. Created OrCad design and PCB library for photodiode sensor.

# Waylon

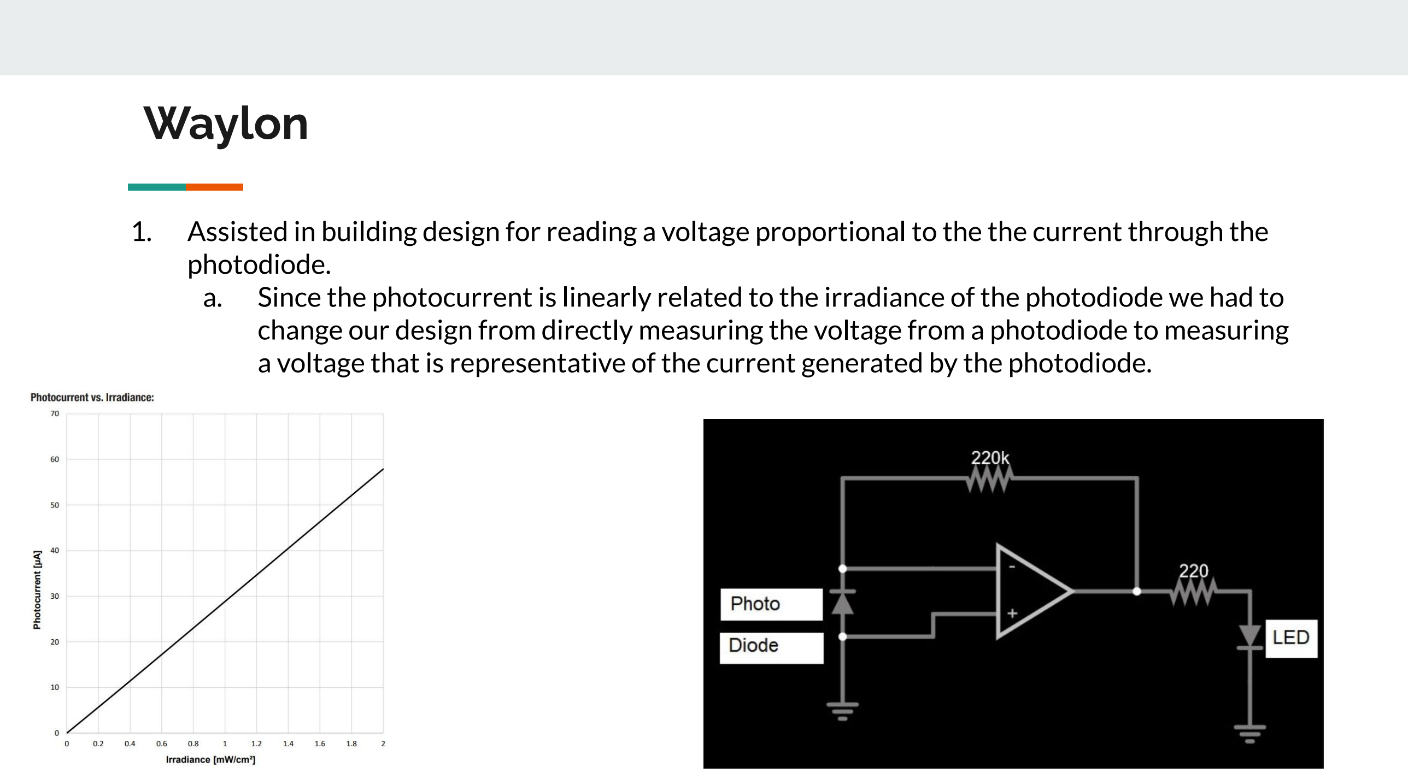
[picture p41: page 3]

1. Assisted in building design for reading a voltage proportional to the the current through the photodiode.
a. Since the photocurrent is linearly related to the irradiance of the photodiode we had to change our design from directly measuring the voltage from a photodiode to measuring a voltage that is representative of the current generated by the photodiode.

# Waylon

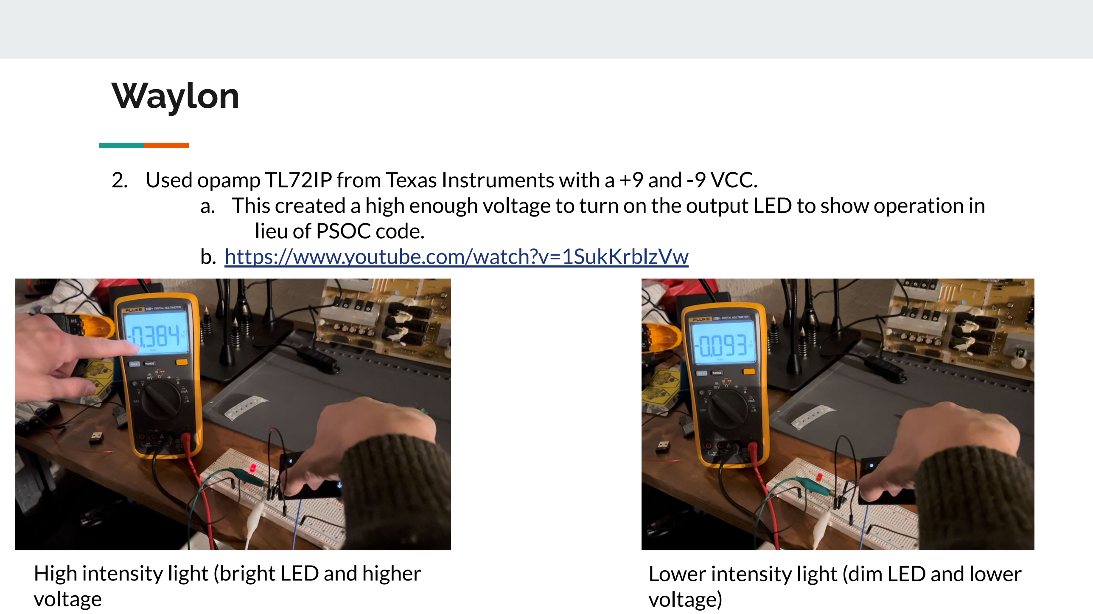
[picture p42: page 4]

2. Used opamp TL72IP from Texas Instruments with a +9 and -9 VCC.
a. This created a high enough voltage to turn on the output LED to show operation in lieu of PSOC code.
b. https://www.youtube.com/watch?v=1SukKrblzVw

High intensity light (bright LED and higher voltage

Lower intensity light (dim LED and lower voltage)

# Waylon

## Next Steps

The next steps to complete the Alpha Prototype are to iterate this design for a grid of photodiodes and use the voltage from the feedback resistor to determine the mix of white and black colors to create a pixel of appropriate grayscale based on luminosity.

# Alina

- Worked with Angel on the PCB for the PSOC, checking all the connections.
- Completed altium library for all the components that will be needed for the future use
- Worked on the orCad block diagram with Viktor to simulate and understand the design of the future prototype

For next week:
- Order the PSoC

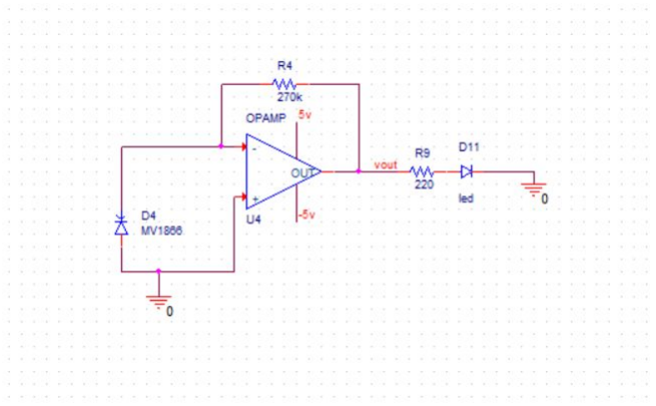
[picture p43: figure]

- Work on the prototype with the group, by including four photodiodes on the board
- Research and decide how the final product will work (op amp for an each amplifier/ or user of multiplexers)

# Viktor

This week:

- Software- Finish coding the ADC Psoc voltage reading as well as implementing the code for the usage of multiplexer cd74hc4067 with Psoc environment.
- Hardware - Implemented a multiplexer test circuit that demonstrate the compatibility of the hardware with the software . Assisted Alina with the OrCad design. Implemented the ADC test circuit the demonstrate the reading of voltage through the Psoc analog pins. (See reference images in slide 11)

Plans for next week:

- Software- Assist the team with design decision on how to generate a grayscale matrix due to a voltage reading from the prototype.
- Hardware - Assist the team with the implementation of the full alpha version.

# Angel

This week:

- PCB Design - Worked with Alina to produce a double check on PSoC PCB and also begin component research for pad sizes and documentation.
- Hardware - Assisted with first prototype bring-up with Waylon & Cassandra of a transimpedance amplifier. With this we were able to measure Vout and light up an LED when flashing photodiode. (See reference images in slide 10)
- Assisted Cassandra in calculating power draw consumption and figuring out what our limitations may be when adding more photodiodes in circuit.

Plans for next week:

- PCB Design - Make sketch of new PCB board for sensor layout and begin footprint
- Hardware - Figure out power consumption and max voltage inputs. For both the sensor and the Psoc GPIO pins we will be using.

# Cassandra

This week:

- Hardware - breadboarded and tested new photodiode circuit design with Waylon and Angel
- Performed power calculations/measurements and refined operating characteristics
- Dropped op-amp power supply voltages from ±9V to ±5V
- Final power assessment: ~20mW/pixel, ~1.25W for an 8x8 pixel array

Plans for next week:

- Design (Hardware) - research expected power draw and operation characteristics for the original pixel design in comparison with the new design
- Hardware - continue building up breadboard prototype to verify design works as intended (ex. test photodiodes with multiplexer)

# Reference Images

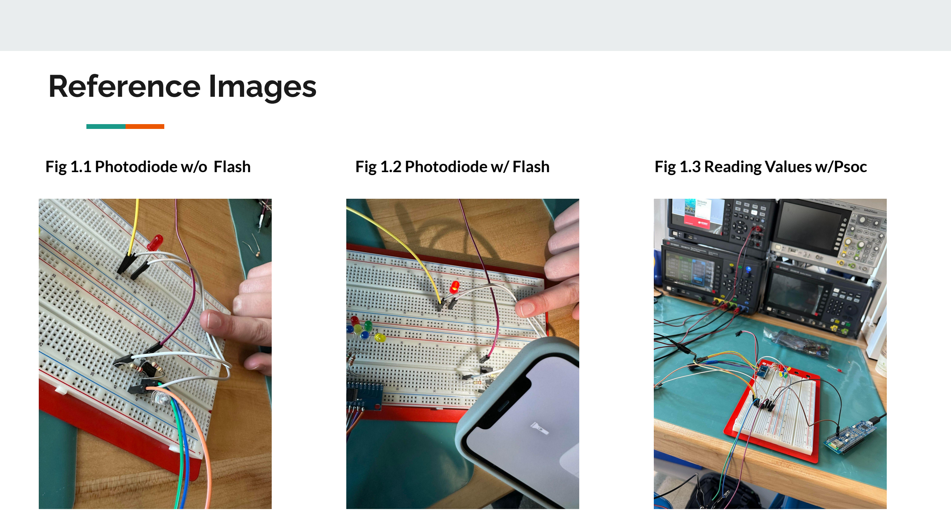
[picture p44: page 10]

Fig 1.1 Photodiode w/o Flash | Fig 1.2 Photodiode w/ Flash | Fig 1.3 Reading Values w/Psoc

# Reference Images

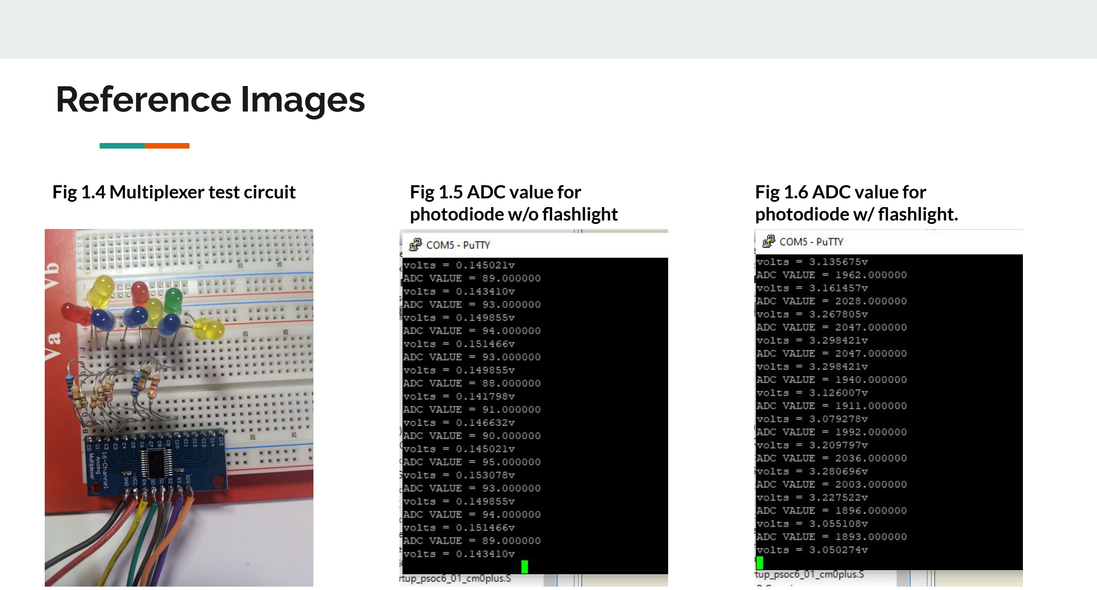
[picture p45: page 11]

Fig 1.4 Multiplexer test circuit | Fig 1.5 ADC value for photodiode w/o flashlight

Fig 1.6 ADC value for
photodiode w/ flashlight.


Gantt Chart Google Slides Link (https://docs.google.com/spreadsheets/d/1wo6-4W0_o3KltN52uBX6xlA9TMSRVw0D3fkvswnoc7U/edit?usp=sharing)

# Bill of Materials Page 1 of 2

Item | Part No. | QTY | Cost | Received
Photodiode (final board) | VBPW34S (https://www.mouser.com/ProductDetail/Vishay-Semiconductors/VBPW34S?qs=Uj7aA%252BCqp8ZDwjFKEZ8K8A%3D%3D) | 100 | $54.00
Photodiode (breadboard) | 1540051EA3590 (https://www.mouser.com/ProductDetail/Wurth-Elektronik/1540051EA3590?qs=u16ybLDytRaft4DtVWb5gA%3D%3D) | 10 | $7.29 | X
MOSFET (n-type) | SQ1922AEEH-T1_GE3 (https://www.mouser.com/ProductDetail/Vishay-Siliconix/SQ1922AEEH-T1_GE3?qs=vLWxofP3U2xgTHPynqtGhQ%3D%3D) | 200 | $60.20 | X
Button | In lab (https://www.sparkfun.com/products/8720) | 5 | $5.25
Header Pins | In lab (https://www.adafruit.com/product/392) | 10 | $4.95
PSOC | In lab | 2 | TBD
Crystal Oscillator | In lab | 1 | TBD
Battery | LIPO Battery (3.7V) (https://www.sparkfun.com/products/13854) | 1 | $10.95
OLED Display | LCD-13003 (https://www.digikey.com/en/products/detail/sparkfun-electronics/LCD-13003/5673774) | 2 | $35.76
Tri-LED | In lab | 5 | TBD
Multiplexer | BOB-13906 (https://www.digikey.com/en/products/detail/sparkfun-electronics/BOB-13906/6193600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) | 2 | $5.90

# Bill of Materials Page 2 of 2

Item | Part No. | QTY | Cost
10KΩ | TBD | 4 | TBD
0Ω Resistor | TBD | 10 | TBD
1KΩ Resistor | TBD | 2 | TBD
10uF Capacitor | TBD | 1 | TBD
22pF Capacitor | TBD | 2 | TBD
4.7KΩ Resistor | TBD | 2 | TBD
330Ω Resistor | TBD | 1 | TBD
470Ω | TBD | 1 | TBD
