vdmulato/EEC136AB-Winter2023-India-Digital-Camera/Weekley reports/Week 2/Week 2 Update.pdf

# EEC136 Digital Camera


### Week 2 Project Update

### Waylon, Cassandra, Viktor, Alina, Angel

# Overview

1. Received most parts for prototyping. Order from DigiKey delayed.
2. Set up GitHub repository.
3. Placed order for Programming Board.
4. Began building prototype board and testing photodiodes.

# Waylon

- Received parts for prototyping.
- | Working through issues with DigiKey order. (Calling customer service | )
- Began testing with photodiodes.
| ○ Can measure voltage from 0v to 0.5v depending on light intensity.
- Assisted Angel with programming board design.
| ○ Placed order for programming board.

Next Week

- Hardware - Receive and assemble programming board.
- Hardware - Verify programming board operation.
- Hardware - Assist in assembling the breadboard prototype.

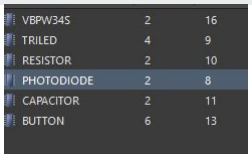
[picture p46: figure]
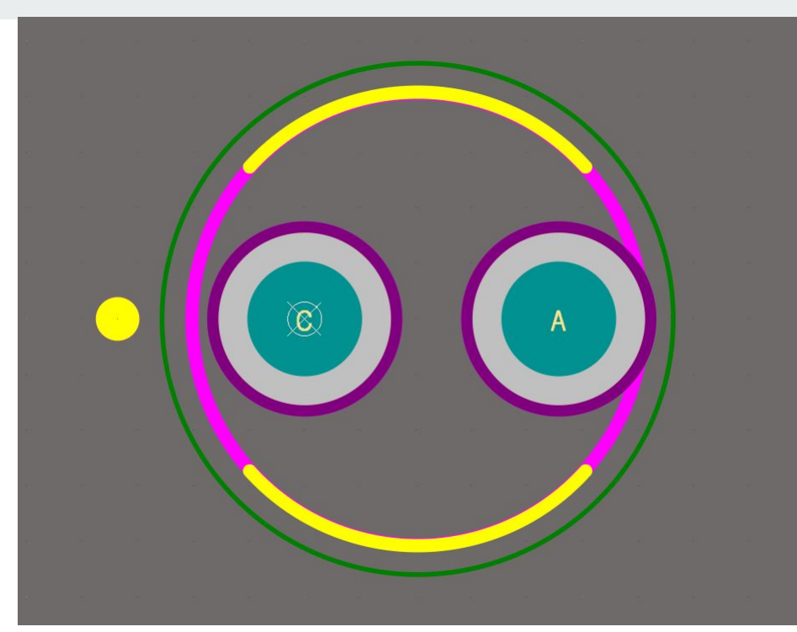
[picture p47: figure]
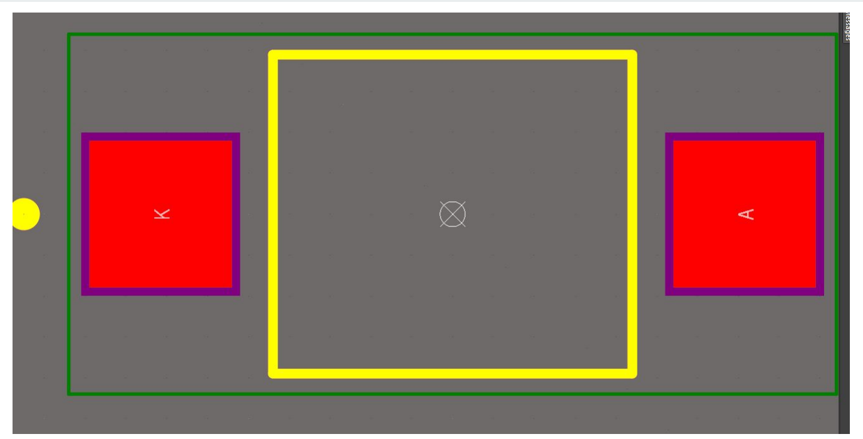
[picture p48: figure]

# Alina

This week:

- Worked on the pcb and schematic library, made components (Some screenshots/not all of what I did this week)
- Researched the best way to do a layout for the components, taking into consideration whether to use amplifier or not

Next week:

- Finish the library for the project, and work on PCB layout after testing the prototype with the group, to understand what

exactly needs to go on the pcb design

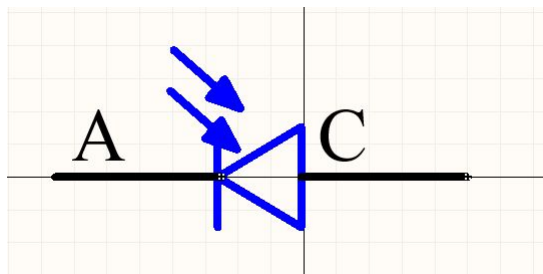
[picture p49: figure]
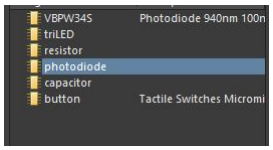
[picture p50: figure]

# Viktor

This week:

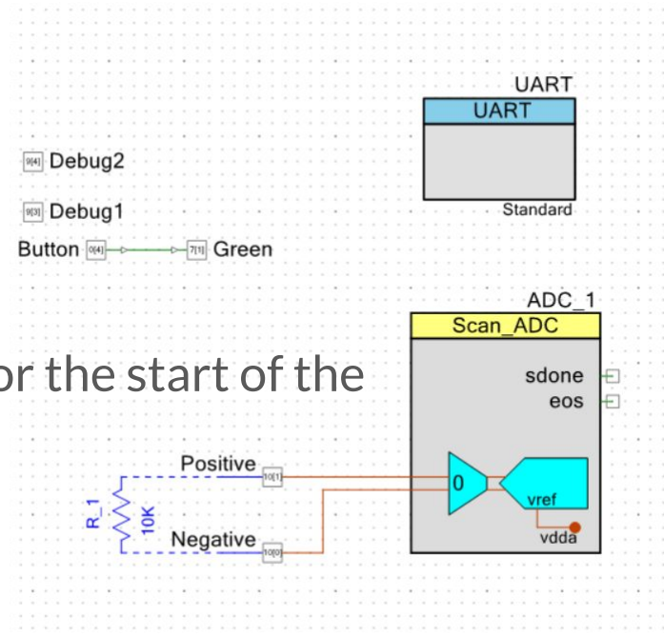
[picture p51: figure]

- Management - Open a Github repository for the project in preparation for the start of the prototype code. https://github.com/vdmulato/DigitalCamera.git
- Firmware - Started implementation of ADC with Psoc environment.

Plans for next week:

- Firmware - Finish the implementation of the code of ADC in addition to multiplexing. The goal of this prototype is to be able to read and array of photodiodes.
- Hardware - Work on prototype breadboard.

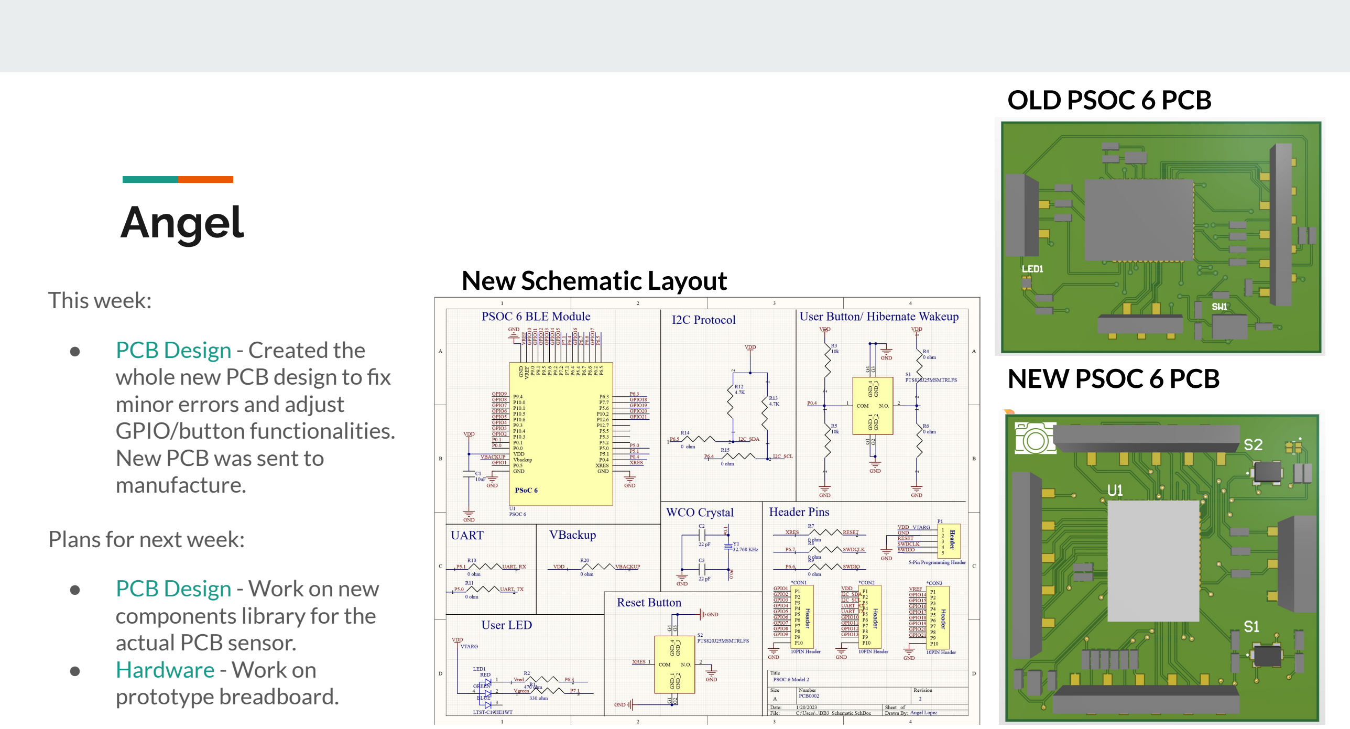
[picture p52: page 6]

# Angel

| New Schematic Layout

OLD PSOC 6 PCB

NEW PSOC 6 PCB

This week:

- PCB Design - Created the whole new PCB design to fix minor errors and adjust
GPIO/button functionalities. New PCB was sent to
manufacture.

Plans for next week:

- PCB Design - Work on new components library for the actual PCB sensor.
- Hardware - Work on
prototype breadboard.

# Cassandra

This week:

- Firmware/Design - Continued research on how photodiode circuit works to better plan logic for the code
- Firmware - Started planning code structure

Plans for next week:

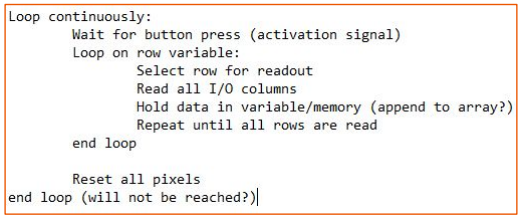
[picture p53: figure]

- Firmware - Work out the details of how to control the pixels with code (which signals to activate and when)
- Hardware - Work on prototype breadboard

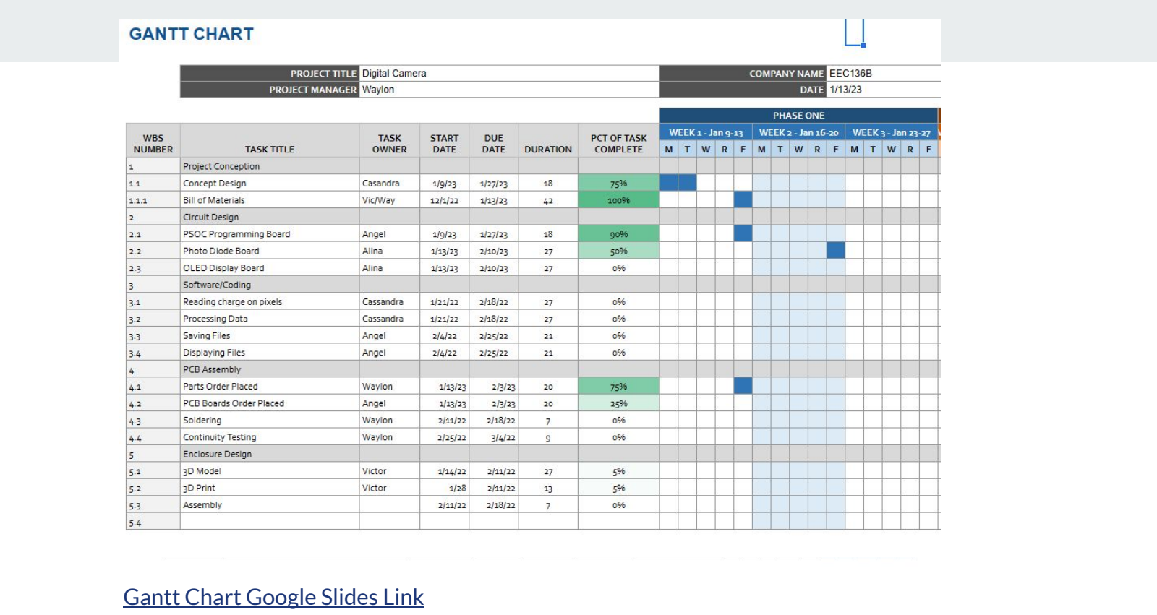
[picture p54: page 8]

Gantt Chart Google Slides Link (https://docs.google.com/spreadsheets/d/1wo6-4W0_o3KltN52uBX6xlA9TMSRVw0D3fkvswnoc7U/edit?usp=sharing)

# Bill of Materials Page 1 of 2

Item | Part No. | QTY | Cost | Received
Photodiode (final board) | VBPW34S (https://www.mouser.com/ProductDetail/Vishay-Semiconductors/VBPW34S?qs=Uj7aA%252BCqp8ZDwjFKEZ8K8A%3D%3D) | 100 | $54.00
Photodiode (breadboard) | 1540051EA3590 (https://www.mouser.com/ProductDetail/Wurth-Elektronik/1540051EA3590?qs=u16ybLDytRaft4DtVWb5gA%3D%3D) | 10 | $7.29 | X
MOSFET (n-type) | SQ1922AEEH-T1_GE3 (https://www.mouser.com/ProductDetail/Vishay-Siliconix/SQ1922AEEH-T1_GE3?qs=vLWxofP3U2xgTHPynqtGhQ%3D%3D) | 200 | $60.20 | X
Button | In lab (https://www.sparkfun.com/products/8720) | 5 | $5.25
Header Pins | In lab (https://www.adafruit.com/product/392) | 10 | $4.95
PSOC | In lab | 2 | TBD
Crystal Oscillator | In lab | 1 | TBD
Battery | LIPO Battery (3.7V) (https://www.sparkfun.com/products/13854) | 1 | $10.95
OLED Display | LCD-13003 (https://www.digikey.com/en/products/detail/sparkfun-electronics/LCD-13003/5673774) | 2 | $35.76
Tri-LED | In lab | 5 | TBD
Multiplexer | BOB-13906 (https://www.digikey.com/en/products/detail/sparkfun-electronics/BOB-13906/6193600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) | 2 | $5.90

# Bill of Materials Page 2 of 2

Item | Part No. | QTY | Cost
10KΩ | TBD | 4 | TBD
0Ω Resistor | TBD | 10 | TBD
1KΩ Resistor | TBD | 2 | TBD
10uF Capacitor | TBD | 1 | TBD
22pF Capacitor | TBD | 2 | TBD
4.7KΩ Resistor | TBD | 2 | TBD
330Ω Resistor | TBD | 1 | TBD
470Ω | TBD | 1 | TBD
