vdmulato/EEC136AB-Winter2023-India-Digital-Camera/Weekley reports/Week 1/Week 1 Update.pdf

# EEC136 Digital Camera


Week 1 Project Update

Waylon, Cassandra, Viktor, Alina, Angel

# Overview

### 1. Bill of Materials finalized and ordered to begin preliminary testing next

week.

### 2. Updated design for programming board, received input from Jacob

# Waylon

- Assisted in determining required parts to order to begin construction of the Beta Prototype.
- Coordinated with Angel on completing PSOC programming board troubleshooting and updated design.
- Placed order for parts necessary for to begin breadboard prototyping.

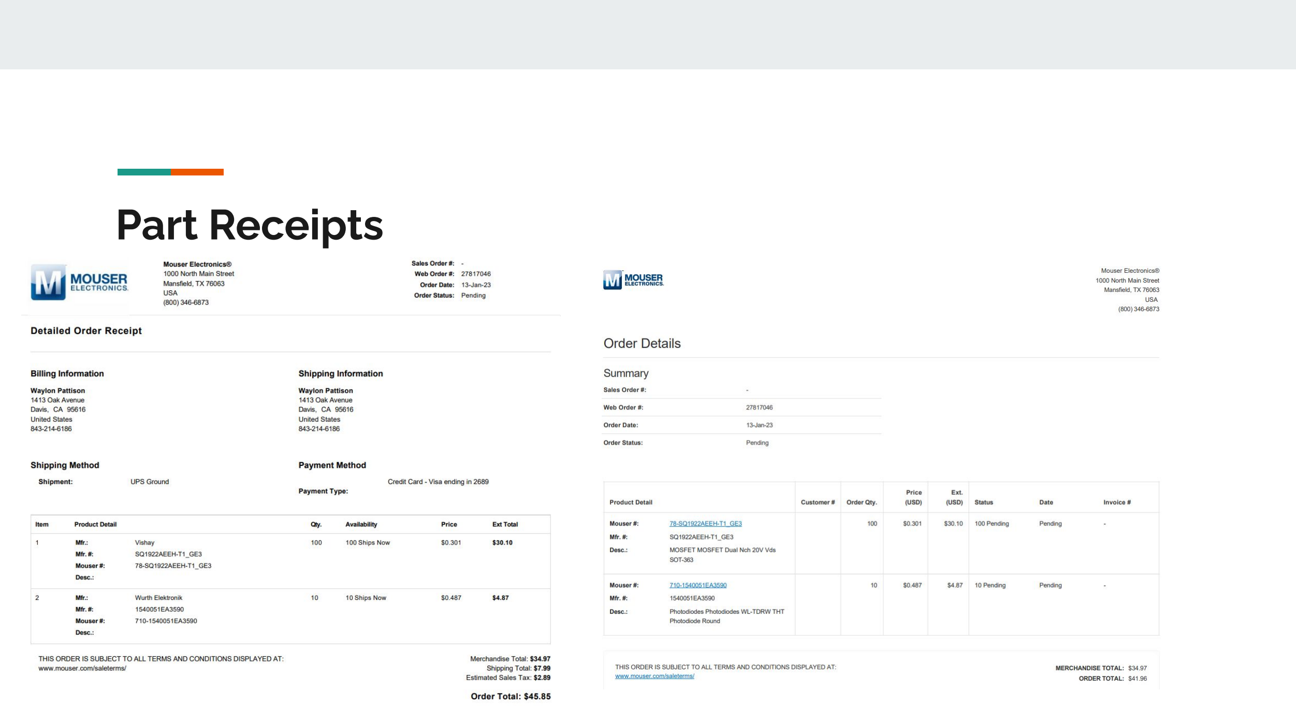
[picture p55: page 4]

# Part Receipts

# Alina

- Searched for the parts to be used
- Discussed and researched the features of the components, and the purpose of it
- Started to work on the photodiode board

# Viktor

- Assist the team in finding specific parts for both the prototype and the final product.
- Discussed with the team about prototype 1 and final product functionality to better understand the learning outcomes of each one.
- Discussed with Jacob about ideas and possible implementation of I2C communication protocol, wich we concluded is not viable nor necessary for this project.

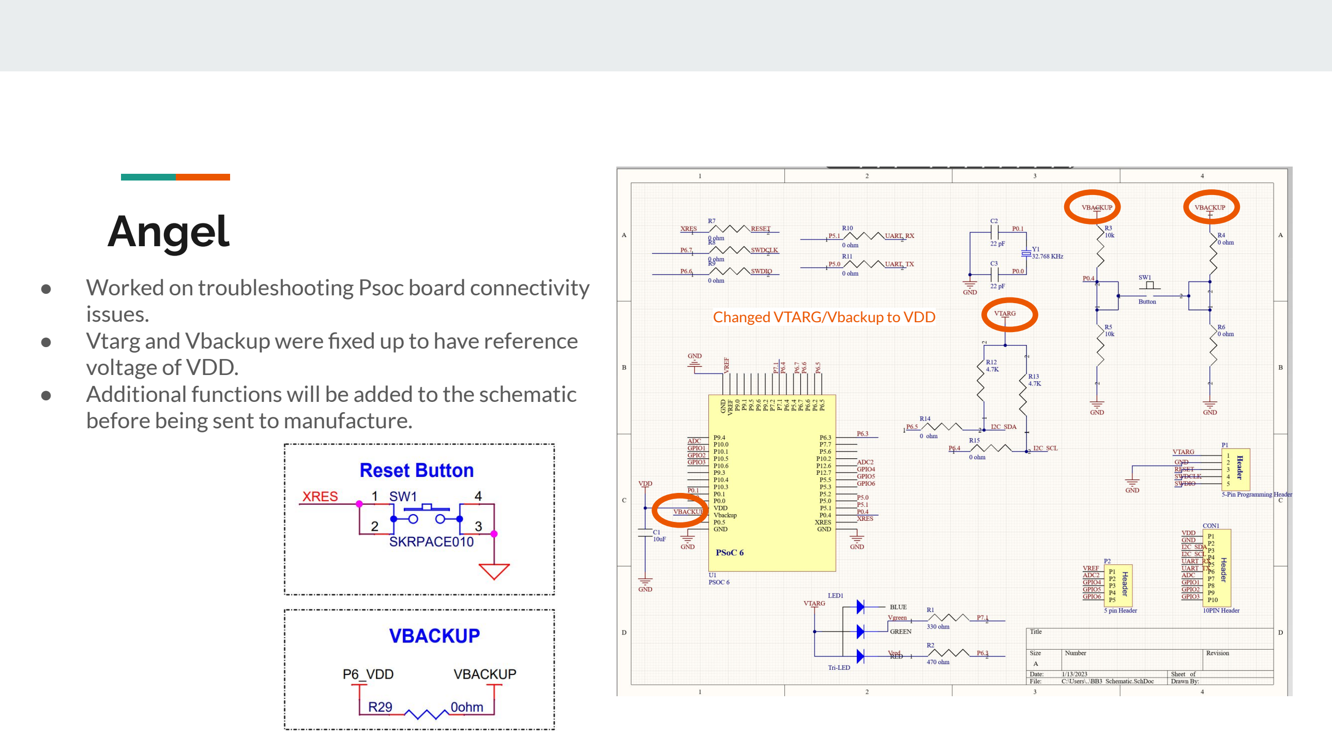
[picture p56: page 7]

# Angel

Changed VTARG/Vbackup to VDD

- Worked on troubleshooting Psoc board connectivity issues.
- Vtarg and Vbackup were fixed up to have reference voltage of VDD.
- Additional functions will be added to the schematic before being sent to manufacture.

# Cassandra

- Selected parts for photodiodes and transistors
- Discussed other part selections with team
- Continued research on CMOS pixels to better understand how they work

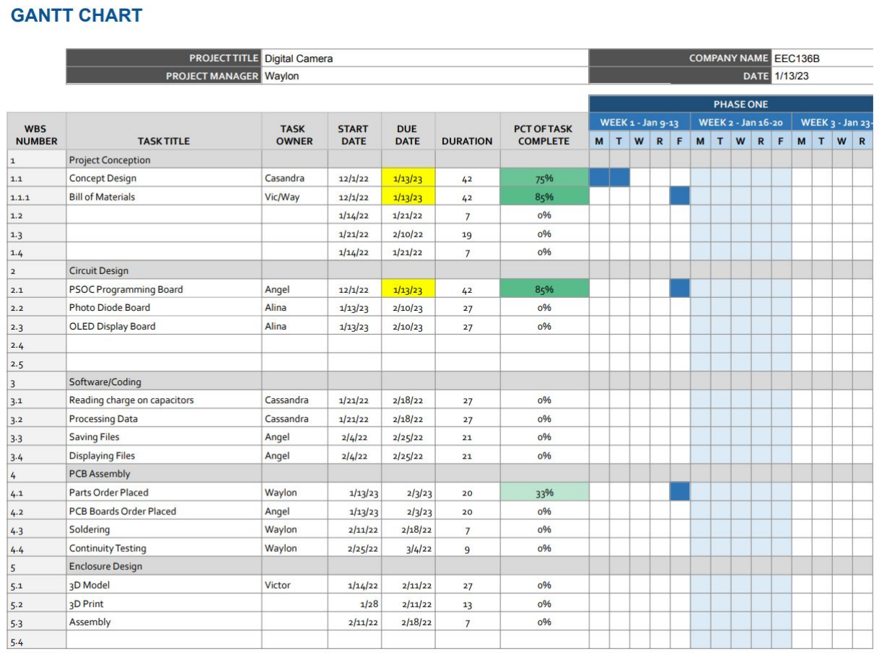
[picture p57: figure]

Gantt Chart Google Slides Link (https://docs.google.com/spreadsheets/d/1wo6-4W0_o3KltN52uBX6xlA9TMSRVw0D3fkvswnoc7U/edit?usp=sharing)

# Bill of Materials Page 1 of 2

Item | Part No. | QTY | Cost
Photodiode (final board) | VBPW34S (https://www.mouser.com/ProductDetail/Vishay-Semiconductors/VBPW34S?qs=Uj7aA%252BCqp8ZDwjFKEZ8K8A%3D%3D) | 100 | $54.00
Photodiode (breadboard) | 1540051EA3590 (https://www.mouser.com/ProductDetail/Wurth-Elektronik/1540051EA3590?qs=u16ybLDytRaft4DtVWb5gA%3D%3D) | 10 | $7.29
MOSFET (n-type) | SQ1922AEEH-T1_GE3 (https://www.mouser.com/ProductDetail/Vishay-Siliconix/SQ1922AEEH-T1_GE3?qs=vLWxofP3U2xgTHPynqtGhQ%3D%3D) | 200 | $60.20
Button | In lab (https://www.sparkfun.com/products/8720) | 5 | $5.25
Header Pins | In lab (https://www.adafruit.com/product/392) | 10 | $4.95
PSOC | In lab | 2 | TBD
Crystal Oscillator | In lab | 1 | TBD
Battery | LIPO Battery (3.7V) (https://www.sparkfun.com/products/13854) | 1 | $10.95
OLED Display | LCD-13003 (https://www.digikey.com/en/products/detail/sparkfun-electronics/LCD-13003/5673774) | 2 | $35.76
Tri-LED | In lab | 5 | TBD
Multiplexer | BOB-13906 (https://www.digikey.com/en/products/detail/sparkfun-electronics/BOB-13906/6193600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) | 2 | $5.90

# Bill of Materials Page 2 of 2

Item | Part No. | QTY | Cost
10KΩ | TBD | 4 | TBD
0Ω Resistor | TBD | 10 | TBD
1KΩ Resistor | TBD | 2 | TBD
10uF Capacitor | TBD | 1 | TBD
22pF Capacitor | TBD | 2 | TBD
4.7KΩ Resistor | TBD | 2 | TBD
330Ω Resistor | TBD | 1 | TBD
470Ω | TBD | 1 | TBD
