vdmulato/EEC136AB-Winter2023-India-Digital-Camera/Pictures/3DView.png

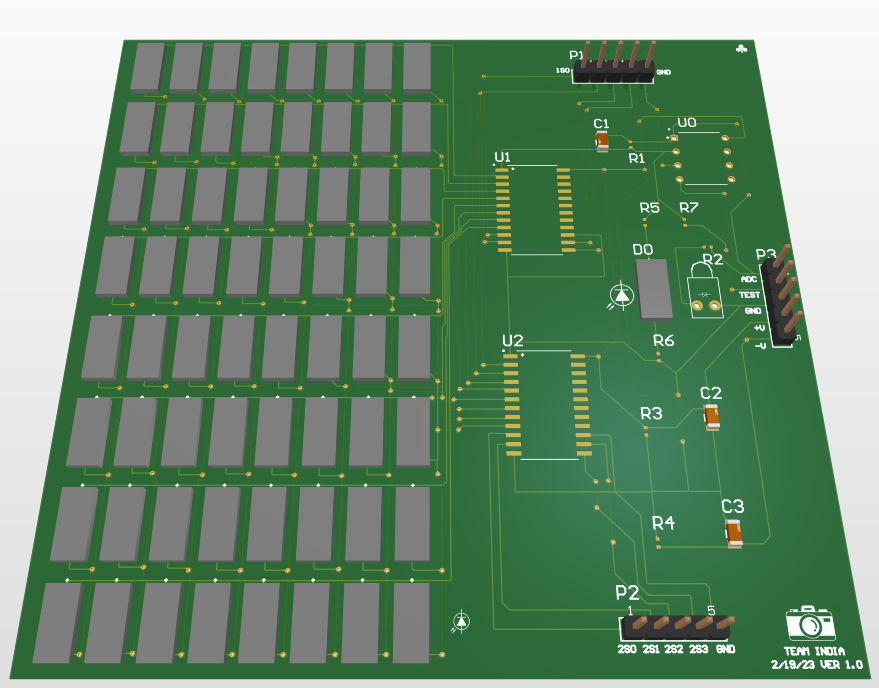
Pictures/3DView.png
