vdmulato/EEC136AB-Winter2023-India-Digital-Camera/Pictures/ADCreading.PNG

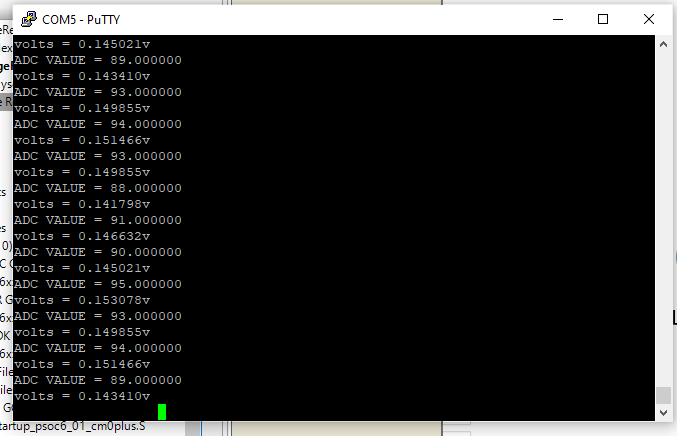
Pictures/ADCreading.PNG
