vdmulato/EEC136AB-Winter2023-India-Digital-Camera/Pictures/Final Case Back.jpg

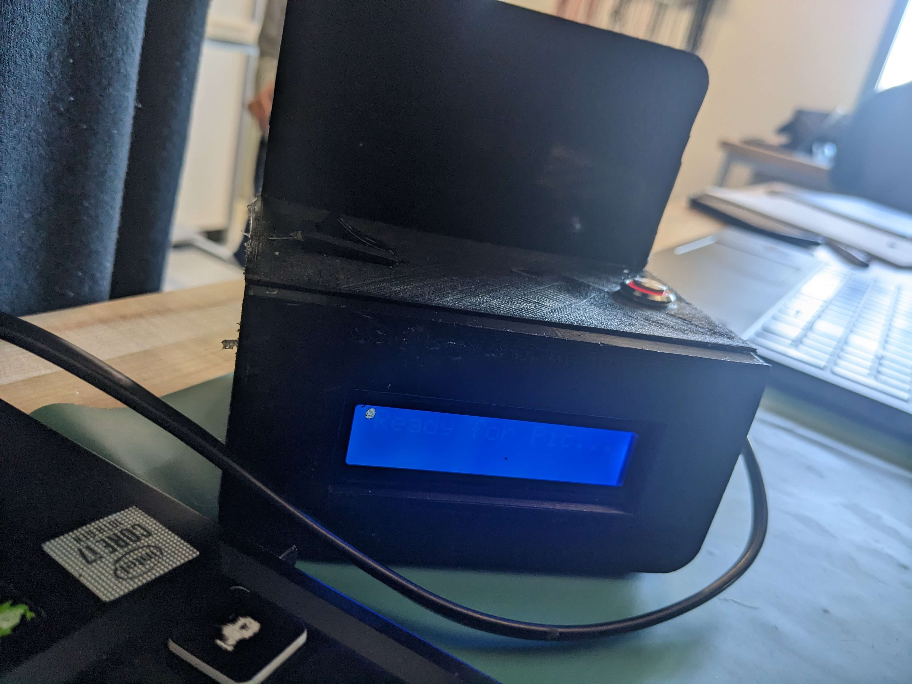
Pictures/Final Case Back.jpg
