vdmulato/EEC136AB-Winter2023-India-Digital-Camera/Pictures/Final Case top.jpg

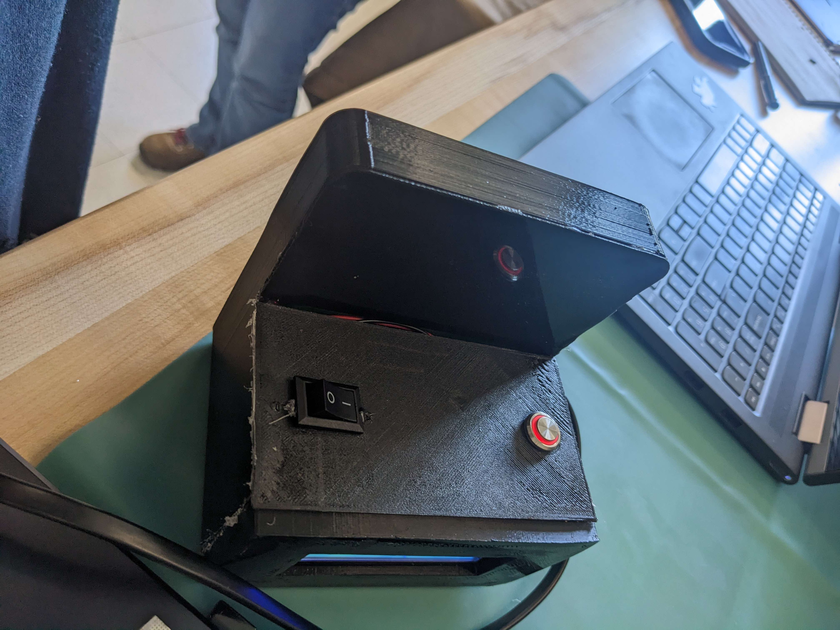
Pictures/Final Case top.jpg
