vdmulato/EEC136AB-Winter2023-India-Digital-Camera/Pictures/Final Case.jpg

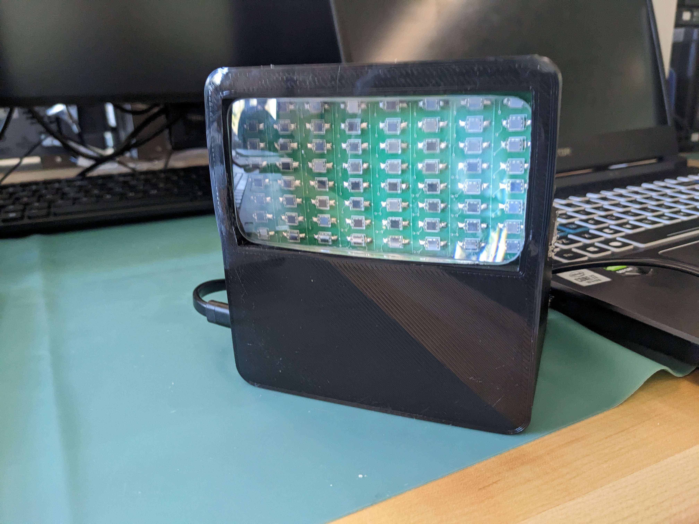
Pictures/Final Case.jpg
