vdmulato/EEC136AB-Winter2023-India-Digital-Camera/Pictures/IMG_4636.jpg

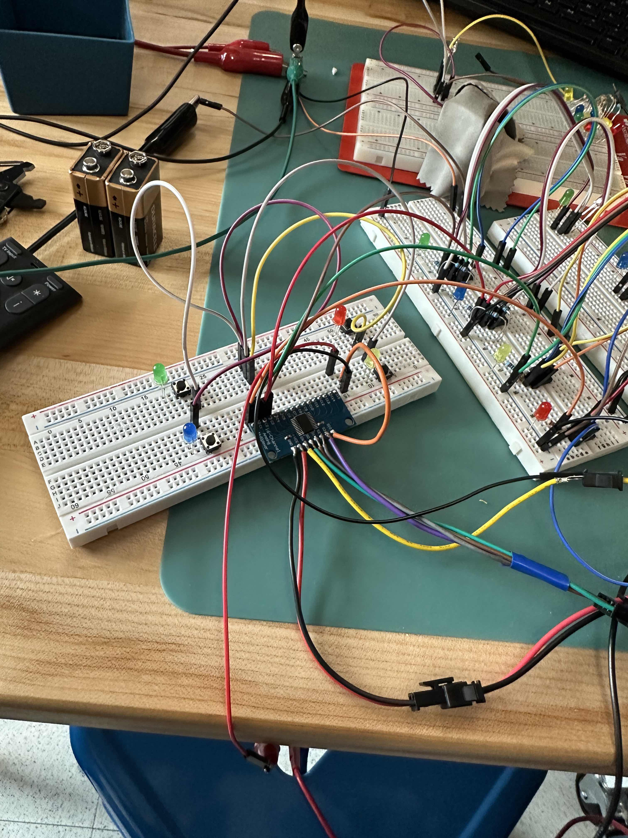
Pictures/IMG_4636.jpg
