vdmulato/EEC136AB-Winter2023-India-Digital-Camera/Pictures/IMG_4637.jpg

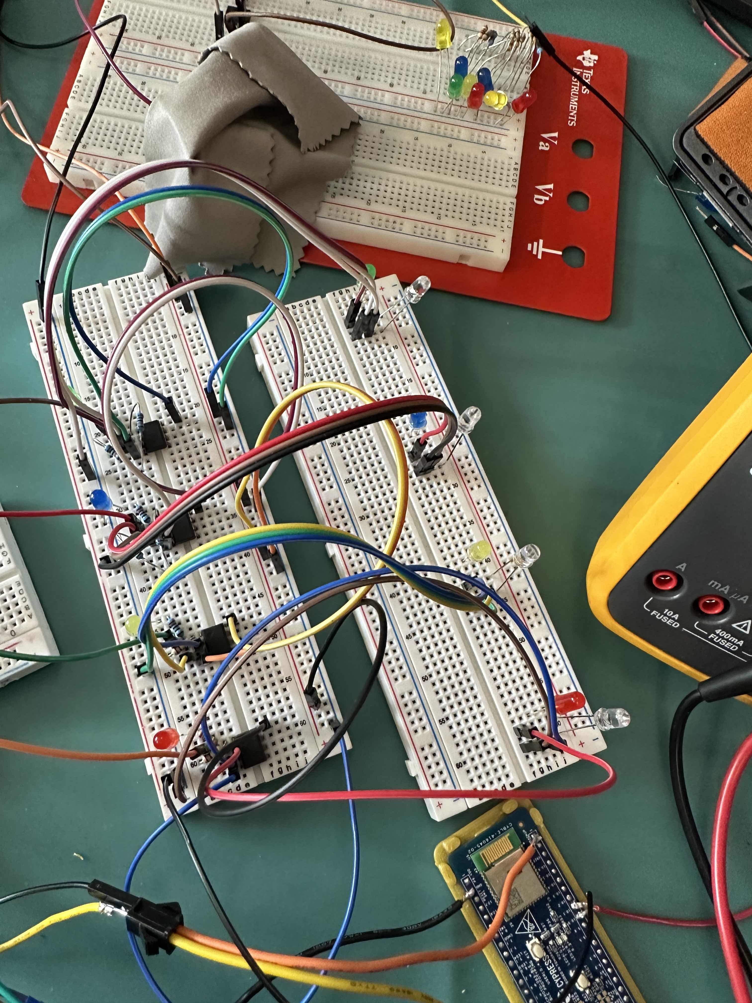
Pictures/IMG_4637.jpg
