vdmulato/EEC136AB-Winter2023-India-Digital-Camera/Pictures/IMG_4638.jpg

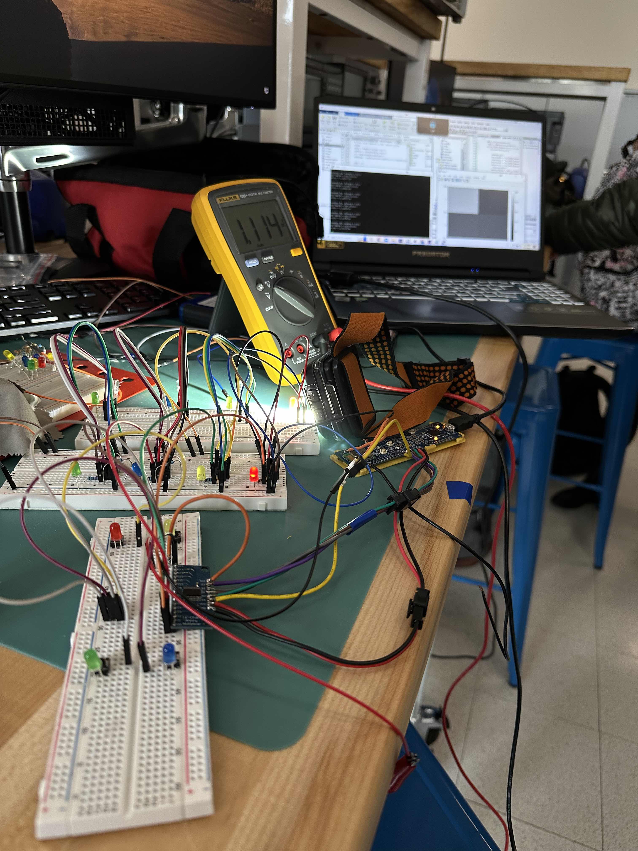
Pictures/IMG_4638.jpg
