vdmulato/EEC136AB-Winter2023-India-Digital-Camera/Pictures/orcad4diodes.PNG

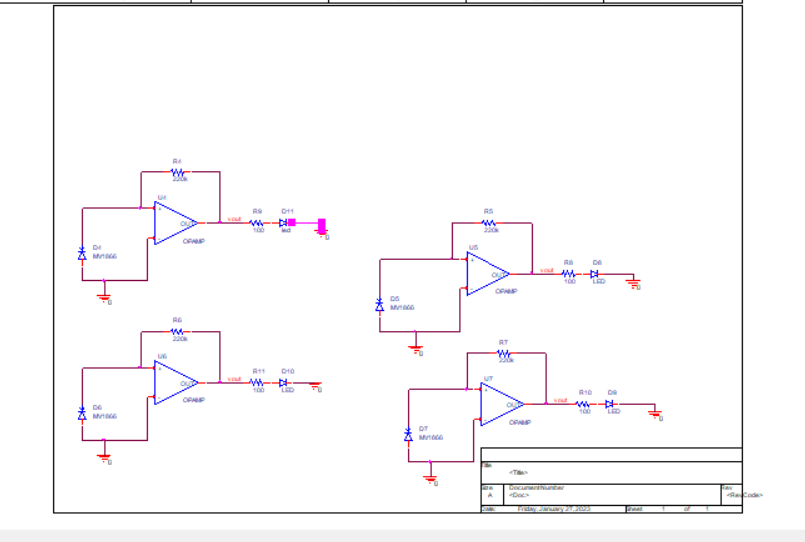
Pictures/orcad4diodes.PNG
