vdmulato/EEC136AB-Winter2023-India-Digital-Camera/Pictures/Sample 1.png

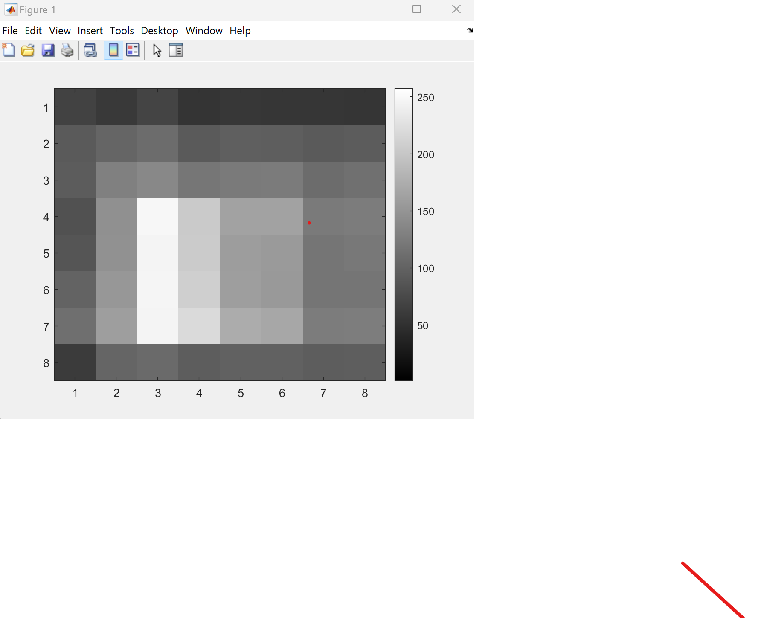
Pictures/Sample 1.png
