vdmulato/EEC136AB-Winter2023-India-Digital-Camera/Pictures/Sample 2.png

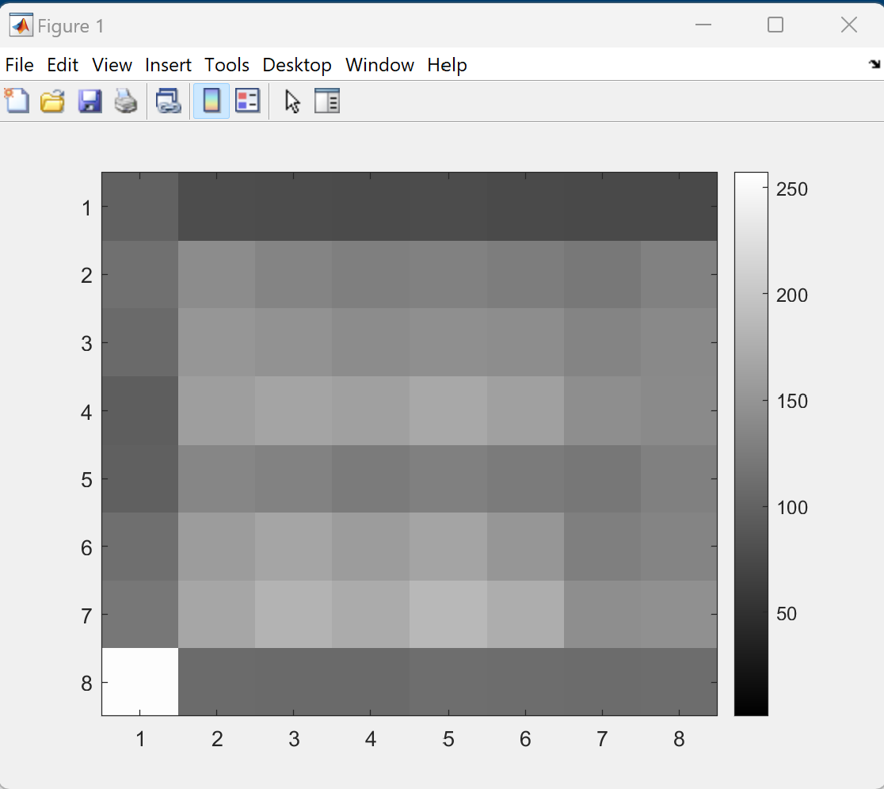
Pictures/Sample 2.png
