vdmulato/EEC136AB-Winter2023-India-Digital-Camera/Pictures/Sample 3.png

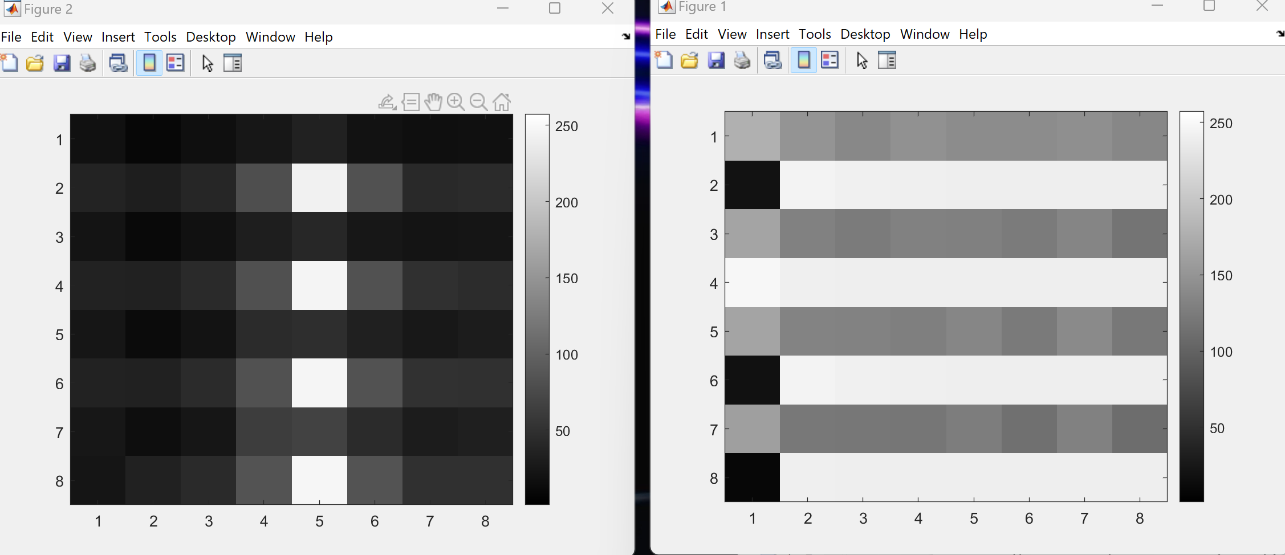
Pictures/Sample 3.png
