vdmulato/EEC136AB-Winter2023-India-Digital-Camera/Pictures/TIA(transimpedance amplifier).png

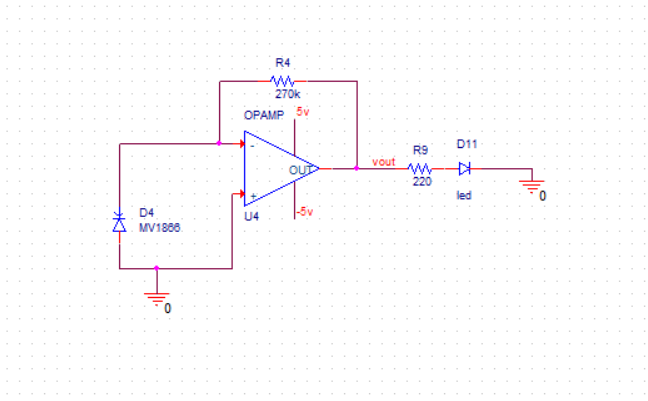
Pictures/TIA(transimpedance amplifier).png
