vdmulato/EEC136AB-Winter2023-India-Digital-Camera/3D files/Backcover.3mf

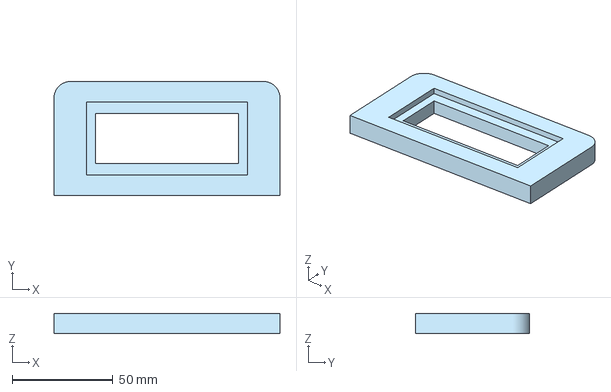
[picture p72: CAD file, 2023-03-24]
3D files/Backcover.3mf
112.0 x 56.5 x 10.0 mm
