vdmulato/EEC136AB-Winter2023-India-Digital-Camera/3D files/Sensor cover.3mf

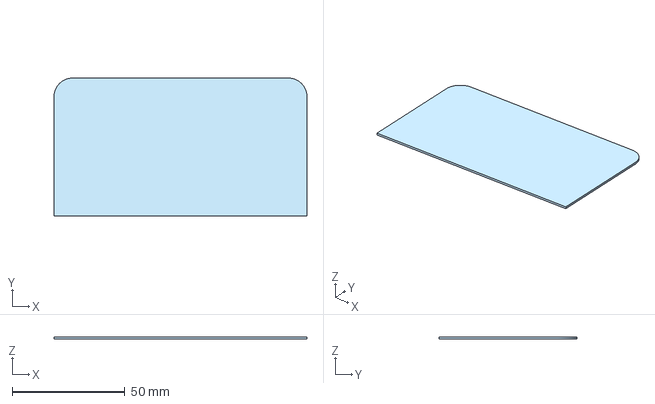
[picture p73: CAD file, 2023-03-24]
3D files/Sensor cover.3mf
112.0 x 61.0 x 1.00 mm
