vdmulato/EEC136AB-Winter2023-India-Digital-Camera/3D files/Pattern.3mf

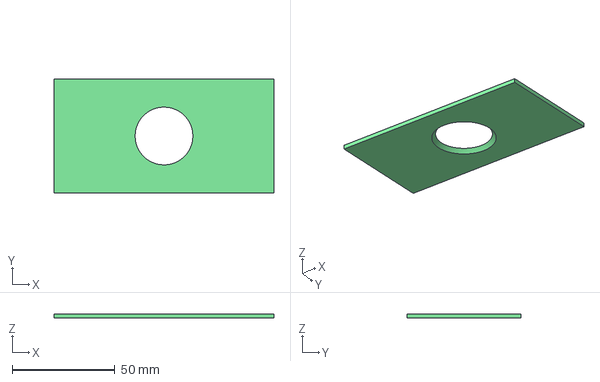
[picture p74: CAD file, 2023-03-24]
3D files/Pattern.3mf
107.1 x 55.6 x 2.14 mm
