vdmulato/EEC136AB-Winter2023-India-Digital-Camera/3D files/Top Cover.3mf

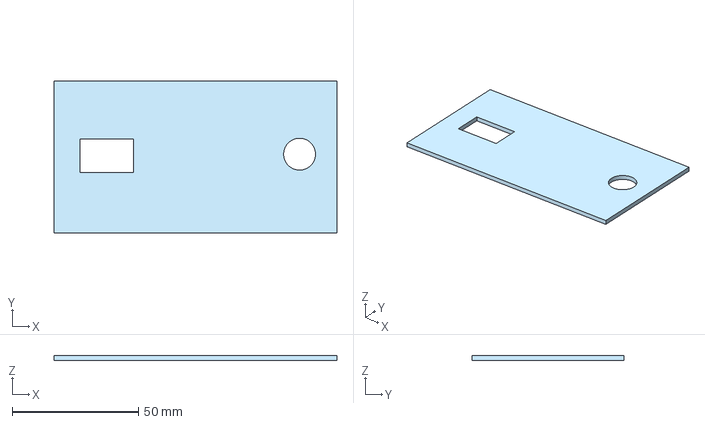
[picture p75: CAD file, 2023-03-24]
3D files/Top Cover.3mf
112.0 x 60.0 x 2.00 mm
