vdmulato/EEC136AB-Winter2023-India-Digital-Camera/3D files/Case.3mf

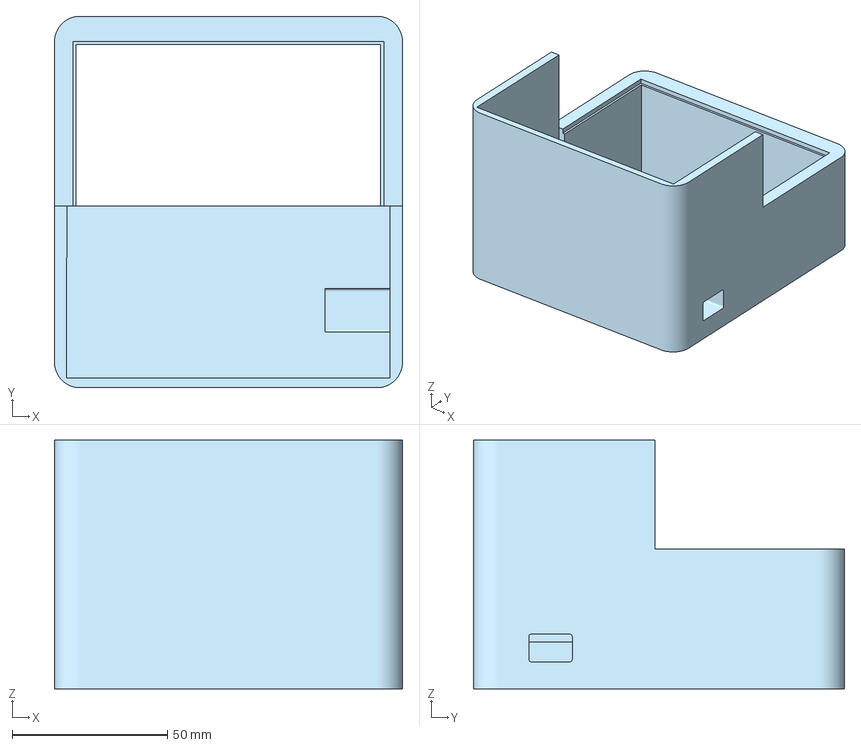
[picture p76: CAD file, 2023-03-24]
3D files/Case.3mf
112.0 x 119.5 x 80.0 mm
