vdmulato/EEC136AB-Winter2023-India-Digital-Camera/Code/VoltageReading.cydsn/codegentemp/Testing_Copy_01_timing.html

# Static Timing Analysis

Project : | Testing_Copy_01
Build Time : | 01/22/23 00:20:08
Device : | CYBLE-416045-02
Temperature : | -40C
VBACKUP : | 3.30
VDDA : | 3.30
VDDA_CSD : | 3.30
VDDD : | 3.30
VDDIO_0 : | 3.30
VDDIO_0_RCV : | 3.30
VDDIO_1 : | 3.30
VDDIO_A : | 3.30
VDDQ : | 3.30
VDD_NS : | 3.30
Voltage : | 3.3

Expand All | Collapse All | Show All Paths | Hide All Paths

+ Timing Violation Section

No Timing Violations

+ Clock Summary Section

Clock | Domain | Nominal Frequency | Required Frequency | Maximum Frequency | Violation
CyClk_Fast | CyClk_Fast | 100.000 MHz | 100.000 MHz | N/A
CyClk_HF0 | CyClk_HF0 | 100.000 MHz | 100.000 MHz | N/A
CyClk_LF | CyClk_LF | 32.000 kHz | 32.000 kHz | N/A
CyClk_Peri | CyClk_Peri | 50.000 MHz | 50.000 MHz | N/A
CyClk_Slow | CyClk_Peri | 50.000 MHz | 50.000 MHz | N/A
ADC_1_intSarClock | CyClk_Peri | 1.000 MHz | 1.000 MHz | N/A
UART_SCBCLK | CyClk_Peri | 1.389 MHz | 1.389 MHz | N/A
CyFLL | CyFLL | 100.000 MHz | 100.000 MHz | N/A
CyILO | CyILO | 32.000 kHz | 32.000 kHz | N/A
CyIMO | CyIMO | 8.000 MHz | 8.000 MHz | N/A
CyPeriClk_App | CyPeriClk_App | 50.000 MHz | 50.000 MHz | N/A

+ Input To Output Section

Source | Destination | Delay (ns)
Button(0)_PAD | Green(0)_PAD | 308.985

Type | Location | Fanout | Instance/Net | Source | Dest | Delay (ns)
Testing_Copy_01 | | 1 | Button(0)_PAD | Button(0)_PAD | Button(0)_PAD | 0.000
Route | | 1 | Button(0)_PAD | Button(0)_PAD | Button(0)/pad_in | 0.000
iocell9 | P0[4] | 1 | Button(0) | Button(0)/pad_in | Button(0)/fb | 1.587
Route | | 1 | Net_127 | Button(0)/fb | Green(0)/pin_input | 304.641
iocell8 | P7[1] | 1 | Green(0) | Green(0)/pin_input | Green(0)/pad_out | 2.757
Route | | 1 | Green(0)_PAD | Green(0)/pad_out | Green(0)_PAD | 0.000
