vdmulato/EEC136AB-Winter2023-India-Digital-Camera/Altium/Psoc custom board/PCB_File/PCB_PDF_Layout.pdf

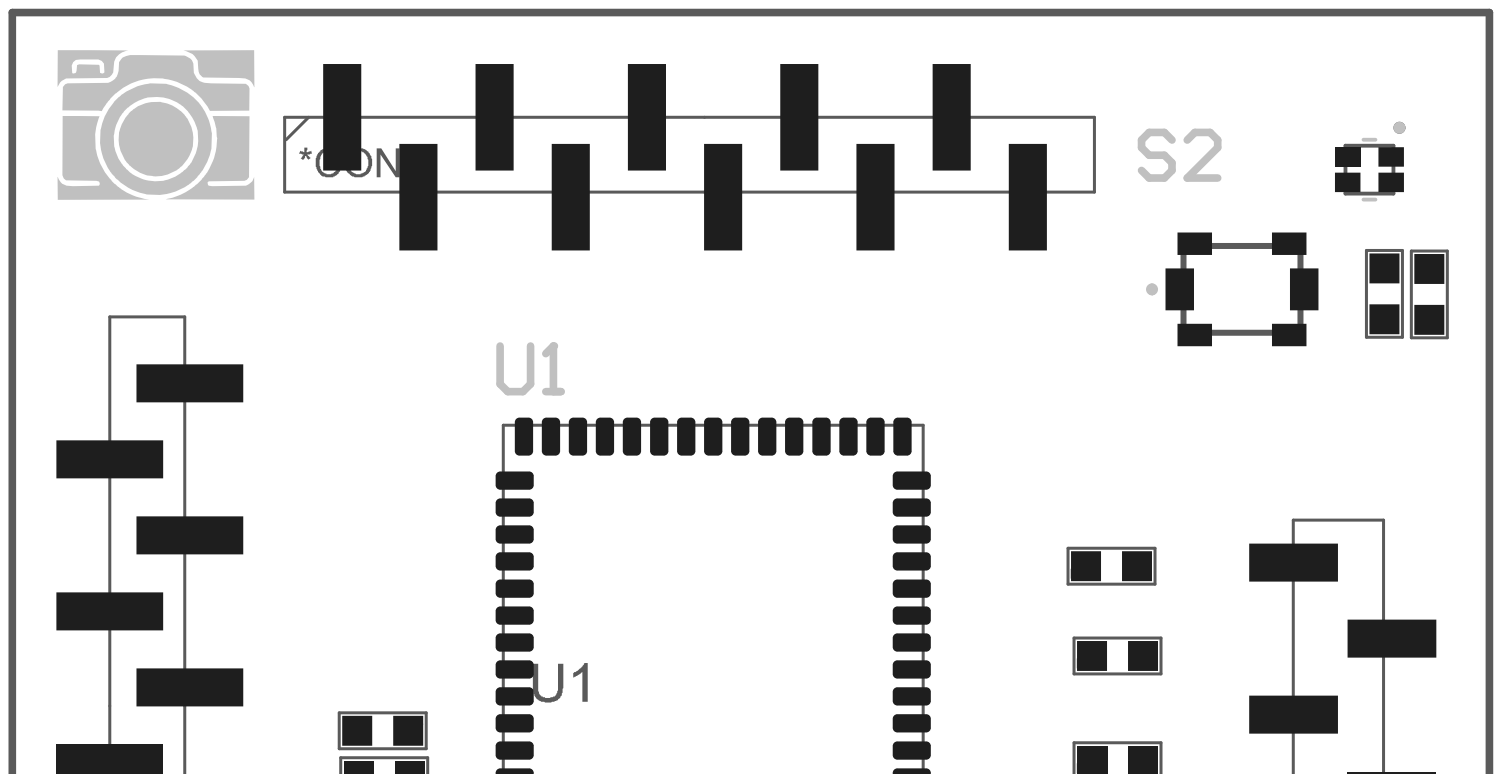
[picture p77: page 1]

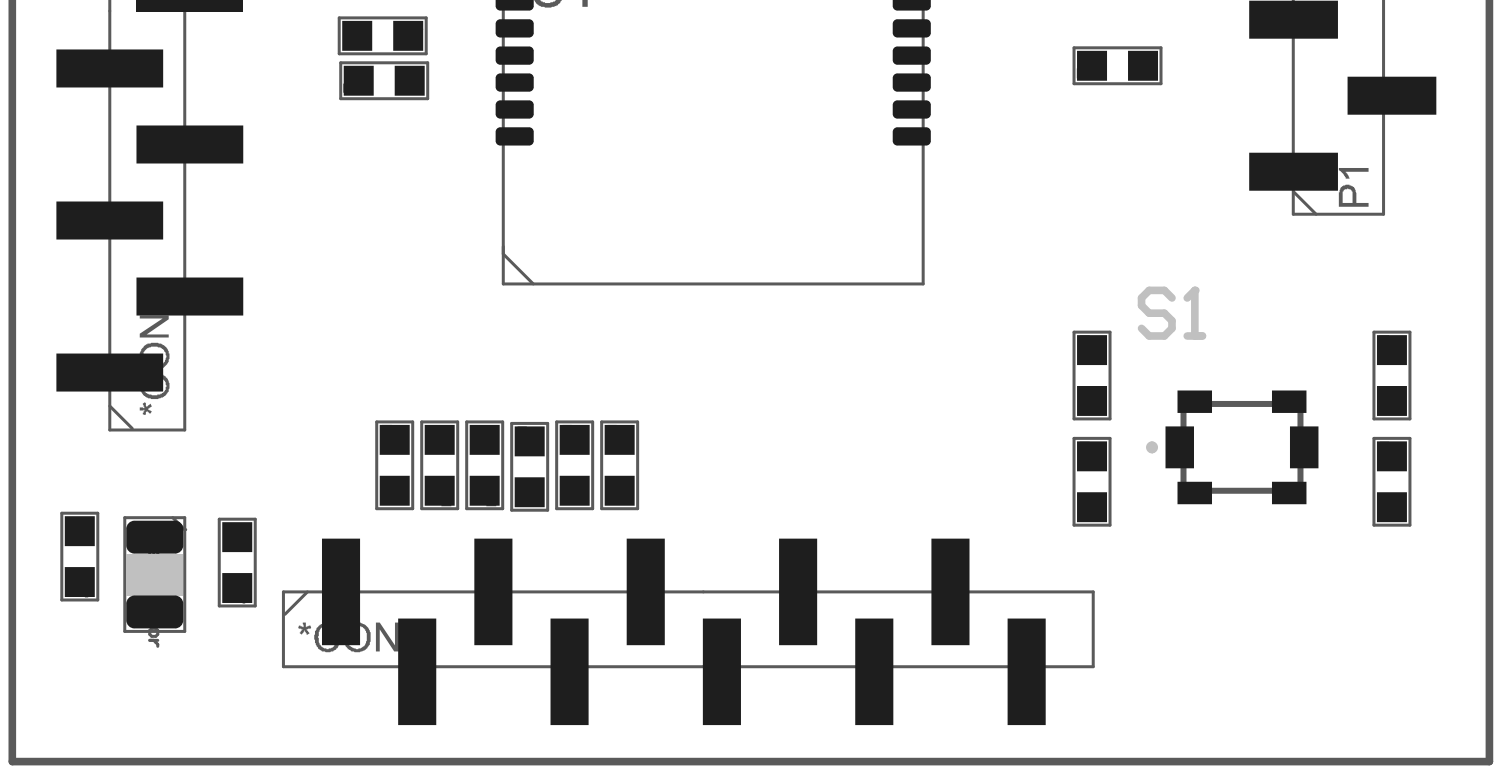
[picture p78: page 2]

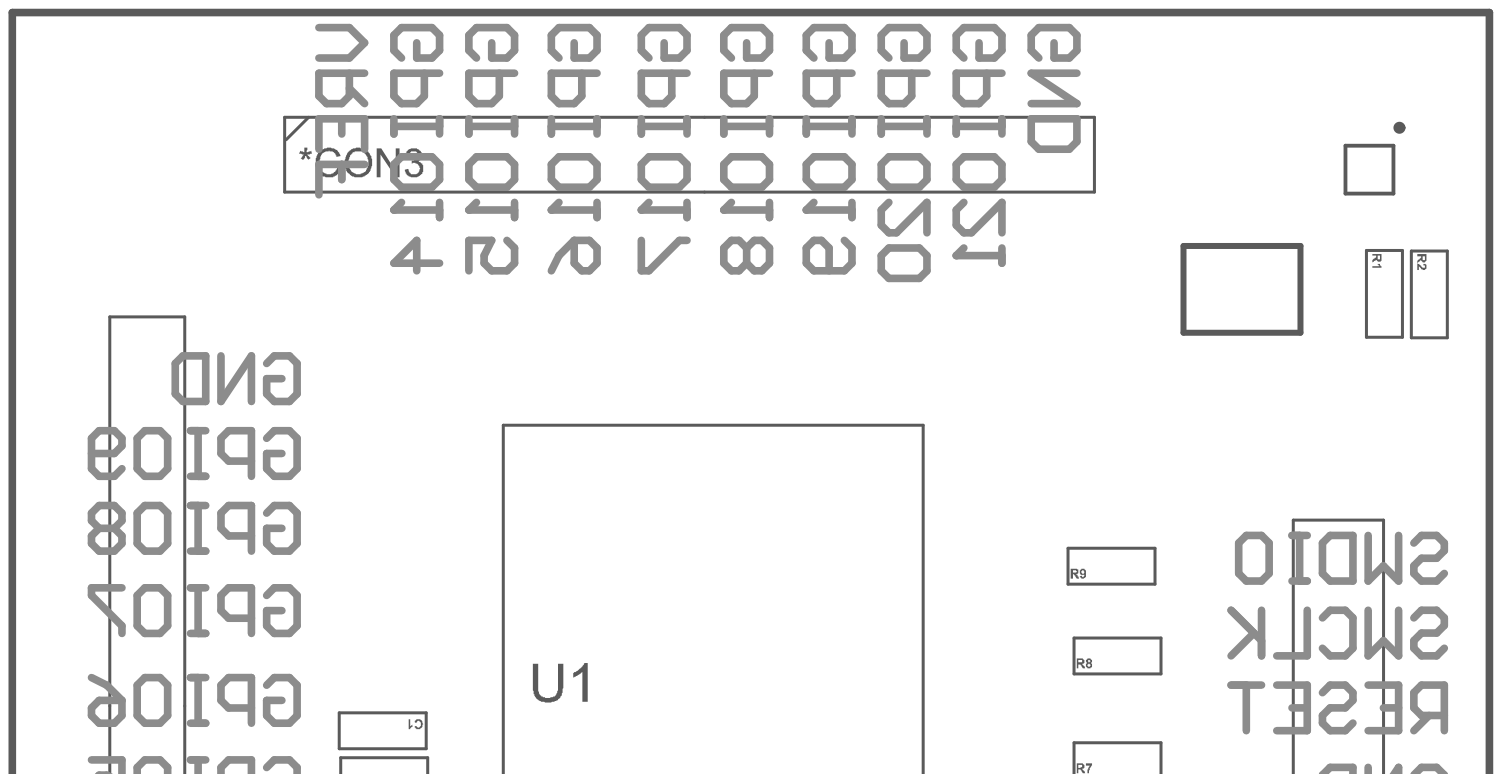
[picture p79: page 3]

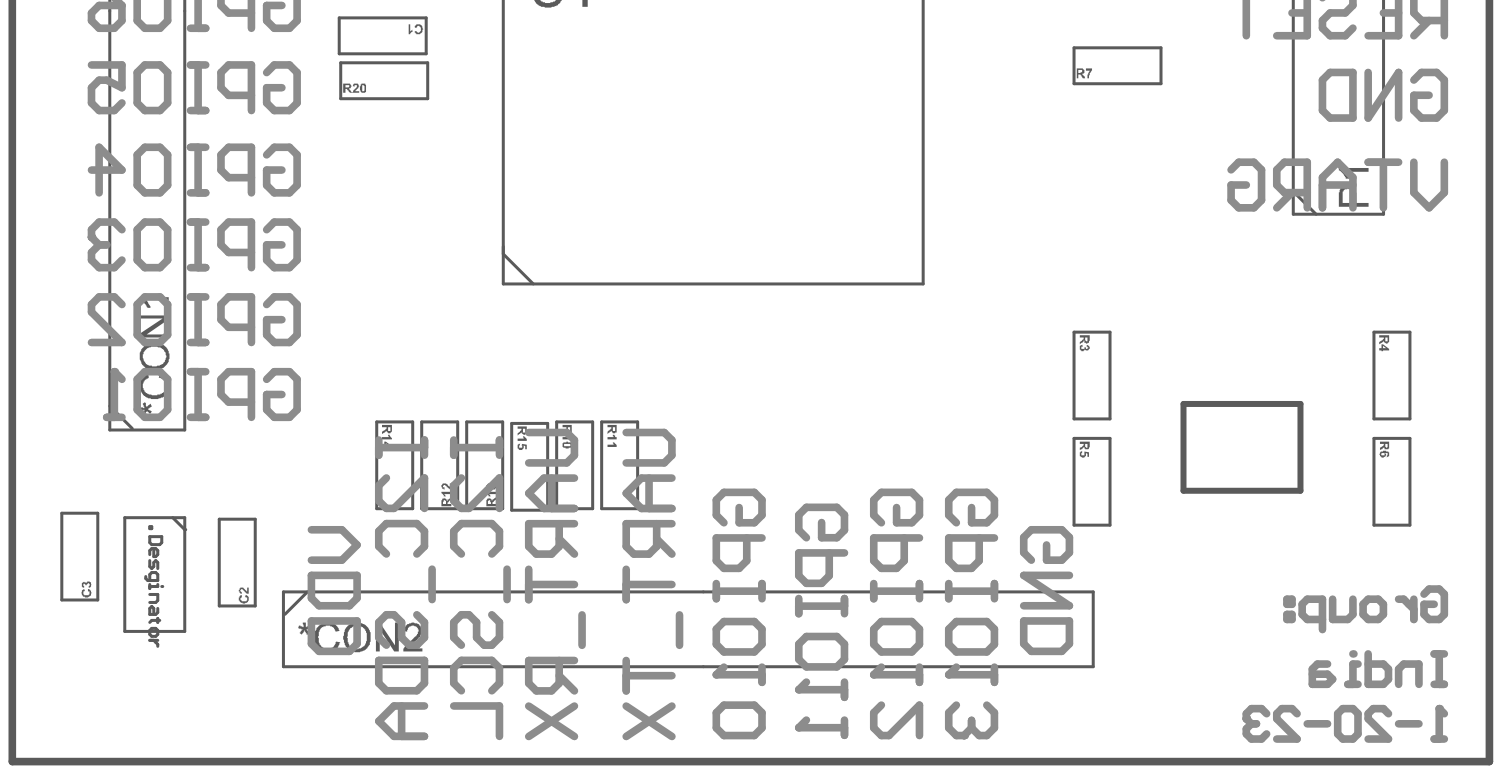
[picture p80: page 4]
