vdmulato/EEC136AB-Winter2023-India-Digital-Camera/(list of files, drawings)

Other design files:
Altium/Final Board/136B.PcbLib
Altium/Final Board/Copy of 136B.SchLib
Altium/Final Board/Sheet1.SchDoc
Altium/Photodiode7_PCB.PcbDoc
Altium/Psoc custom board/3 Breakout Board.PrjPcb
Altium/Psoc custom board/BB3_Schematic.SchDoc
Altium/Psoc custom board/PSOC_PCB.PcbDoc
Hardware/PSoC_PCB/PSoC_Library/SeniorDesign.PcbLib
Hardware/PSoC_PCB/PSoC_Library/SeniorDesign.SchLib
OrCAD/TIA.DSN
OrCAD/TIA.opj
