vdmulato/EEC136AB-Winter2023-India-Digital-Camera/Code/Alpha_betterversion.cydsn/main_cm0p.c

/* ========================================
 *
 * Copyright YOUR COMPANY, THE YEAR
 * All Rights Reserved
 * UNPUBLISHED, LICENSED SOFTWARE.
 *
 * CONFIDENTIAL AND PROPRIETARY INFORMATION
 * WHICH IS THE PROPERTY OF your company.
 *
 * ========================================
*/
#include "project.h"
#include "stdio.h"

int main(void)
{
    __enable_irq(); /* Enable global interrupts. */
    /* Enable CM4.  CY_CORTEX_M4_APPL_ADDR must be updated if CM4 memory layout is changed. */
    Cy_SysEnableCM4(CY_CORTEX_M4_APPL_ADDR); 

    /* Place your initialization/startup code here (e.g. MyInst_Start()) */
    UART_Start();
    setvbuf(stdin,NULL,_IONBF,0);
    char c;
    
    
}

/* [] END OF FILE */
