vdmulato/EEC136AB-Winter2023-India-Digital-Camera/(commit log)

2023-01-23 Created Code folder and imported project
    This is the first version for the code that reads an analog voltage implementing ADC specifically Scan_ADC
    [Testing_Copy_01.sdf]
2023-01-23 Rename
    Change name to VoltageReading
    [Testing_Copy_01.sdf]
2023-01-23 Edit code
    Change variable names and add comments
    [VoltageReading.sdf]
2023-01-25 Added multiplexer code
    Multiplexer code for chip CD74HC4067 ready. In this code we use it as output.
    [Multiplexer.sdf]
2023-01-26 Update VoltageReading.cywrk.dmula
    minor changes
2023-01-27 uploaded orcad schematic
    Schematic for prototype V0
    [TIA.DSN, TIA.opj]
2023-01-27 Added pictures of adc
    for prototype 0, adc values with light and no light
2023-01-28 Added Psoc PCB Files
    [SeniorDesign.PcbLib, SeniorDesign.SchLib]
2023-01-28 File system organization
    [3 Breakout Board.PrjPcb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]
2023-01-28 Just testing
    [TIA.opj]
2023-02-04 Changes for prototype
    Submitted matlab code
    update psoc code
    upload new pictures
    [Alpha.sdf]
2023-02-13 Testing + added cassandras new matlab code
    Just testing.
    [Alpha.sdf]
2023-02-14 MUX symbol&footprint
2023-02-14 Schematic of final board unfinished
    [136B.PcbLib, Copy of 136B.SchLib, Sheet1.SchDoc]
2023-02-17 Work on schematic
    Need amplifier.. can't find it on the slides
    [Sheet1.SchDoc]
2023-02-17 added amplifier
    [136B.PcbLib, Copy of 136B.SchLib, Sheet1.SchDoc]
2023-02-17 progress on schematic
    [Sheet1.SchDoc]
2023-02-18 fixed ADC code
    [VoltageReading.sdf]
2023-02-18 Added serial/UART version of displayImage
    This version of displayImage can read the data sent to the COM port directly. Instructions are included in the code comments.
2023-02-19 Updated Schematic
    [Sheet1.SchDoc]
2023-02-25 Updating code for beta prototype
    Added new functions and pins
    [Alpha.sdf]
2023-03-09 Beta prototype
    Added the psoc code for beta and matlab final code for beta
    [clcd_063proto_210114.sdf]
2023-03-24 Final details
    [Alpha.sdf, Alpha_betterversion.sdf, Backcover.3mf, Case.3mf, Multiplexer.sdf, Pattern.3mf, Sensor cover.3mf, Top Cover.3mf]
